pvillacorta/TP1SE/00 - Documentacion/Anotaciones/Cosas pendientes.jpeg

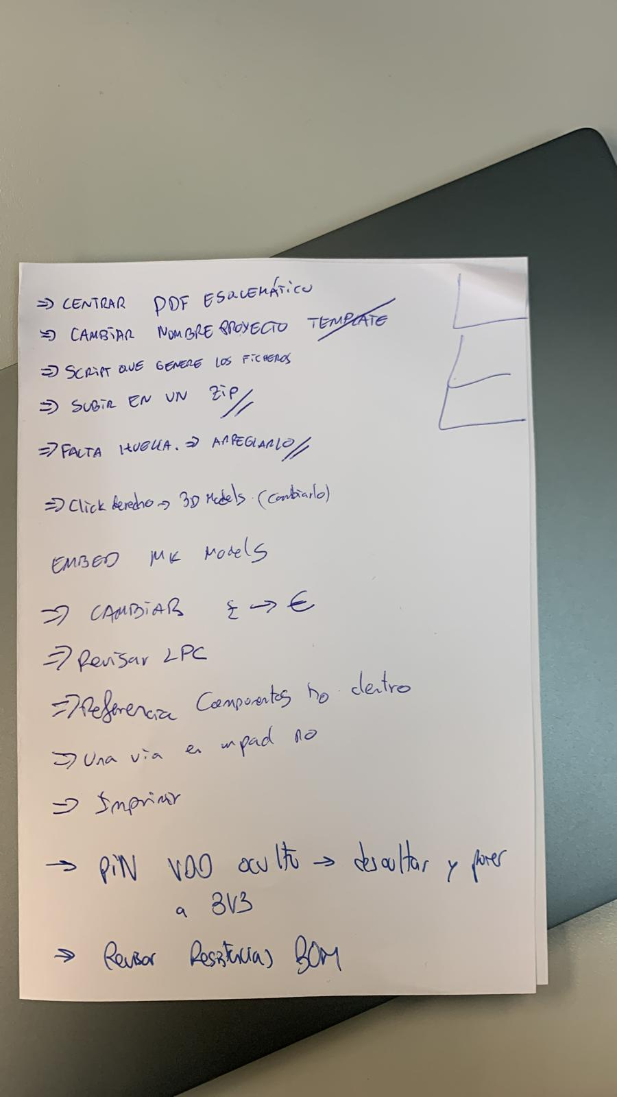
00 - Documentacion/Anotaciones/Cosas pendientes.jpeg
