pvillacorta/TP1SE/00 - Documentacion/Anotaciones/3.png

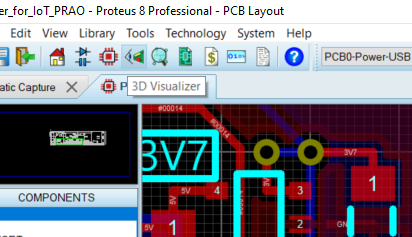
00 - Documentacion/Anotaciones/3.png
