pvillacorta/TP1SE/05 - Entregas/Entrega_21_01_23/02 - Design/Layouts/PCB2 - Mech.pdf

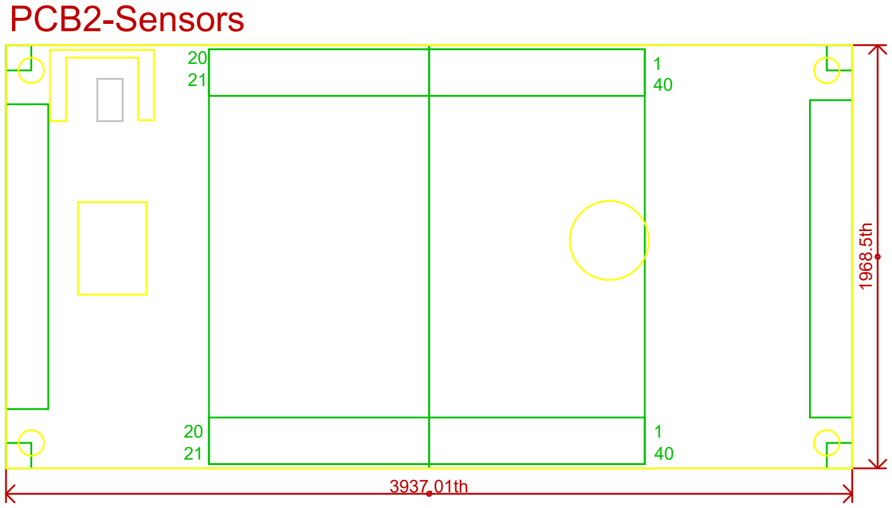
[picture p3: figure]
PCB2-Sensors
