pvillacorta/TP1SE/05 - Entregas/Entrega_21_01_23/02 - Design/Layouts/PCB0 - Mech.pdf

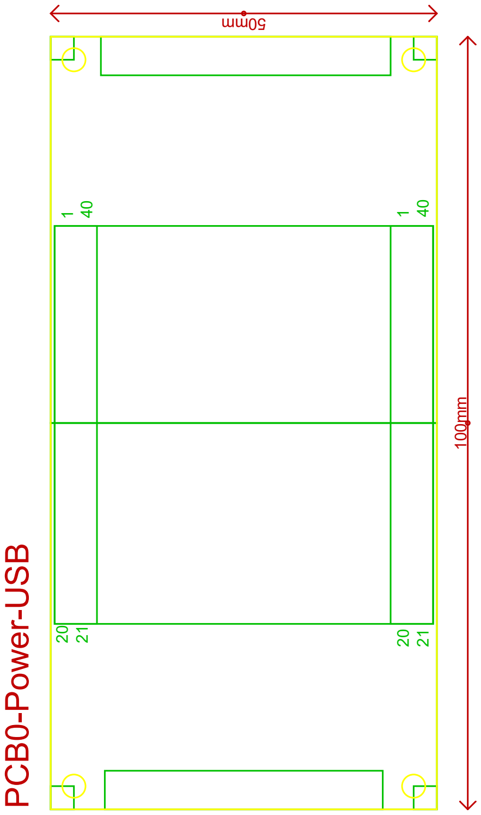
[picture p4: figure]
PCB0-Power-USB 100mm
