pvillacorta/TP1SE/05 - Entregas/Entrega_21_01_23/02 - Design/Layouts/PCB1 - Mech.pdf

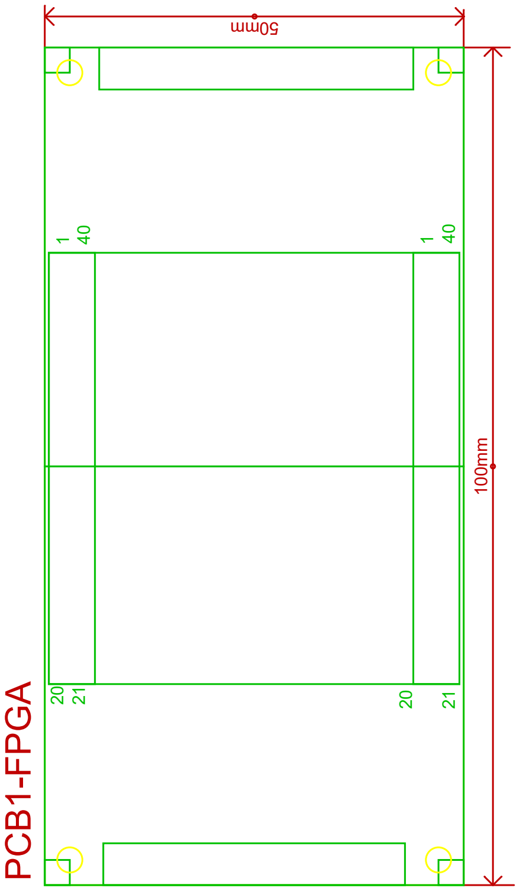
[picture p5: figure]
PCB1-FPGA
