pvillacorta/TP1SE/05 - Entregas/Entrega_21_01_23/03 - AnalisisConsumo/Analisis Electrico y Termico PCB0.pdf

Nombre | Consumo (mA) | Quiescent current (mA) | Condiciones | Ubicación | Notas
Puente USB-Serie CY7C65213-28PVXI | 13 | - | max 18 mA | Página 9. Datasheet
Regulador de tension MCP1725 (3V7) | - | 0,22 | máx 500 mA | Página 5. Datasheet | En el regulador no hay consumo de corriente, unicamente hay
| | | | | corriente quiescente, que nos situamos en el peor caso.
Nombre | Consumo (mA) | Quiescent current (mA) | Condiciones | Ubicación | Notas
Cargador Bateria MCP73831T-2ACIOT | 1,5
| | - | Cargando bateria | Página 3. Datasheet | Alimentando el datalogger con la batería no existe este consumo,
| | | | | estamos en situación máxima, la típica es 0,51mA. Si la carga está
| | | | | completa tenemos 0,053 mA de típica y 0,52 mA de máxima.
Nombre | Consumo (mA) | Quiescent current (mA) | Condiciones | Ubicación | Notas
LED rojo | 30 | - | a 25ºC | Página 2 Datasheet
LED verde | 30 | - | a 25ºC | Página 2 Datasheet
Microcontrolador ARM LPC1112FD20102/52 | 100 | - | por cada pin de alimentación (hay 1) | Página 58. Datasheet
Consumo total | 174,5
Nombre | Potencia (mW) = I * V | Resistencia térmica | Temperatura | Ubicación | Notas
Cargador Bateria MCP73831T-2ACIOT | 5,55 | 230ºC/W | - | Página 5. Datasheet
Regulador de tension MCP1725 (3V7) | 1,1 | Theta(JA) = 163ºC/W | 0,132682 ºC + Ta | Página 7. Datasheet
Puente USB-Serie CY7C65213-28PVXI | 65 | 62ºC/W | - | Página 24. Datasheet | THJ: Package 28pin SSOP
LED rojo | 75 | - | - | Página 2. Datasheet
LED verde | 75 | - | - | Página 2. Datasheet
Microcontrolador ARM LPC1112FD20102/52 | 330 | - | - | Página 58. Datasheet

Componentes a 3V7

Componentes a 3V3

Componentes a 5V

Análisis Eléctrico

Análisis Térmico
