pvillacorta/TP1SE/05 - Entregas/Entrega Semana 12/Proyecto/README.txt

Hay dos versiones del proyecto Proteus:

- Datalogger_for_IoT_PRAO_montado.pdsprj: contiene el proyecto que está montado físicamente
- Datalogger_for_IoT_PRAO.pdsprj: contiene el proyecto correcto, con los cambios realizados (ej: pines LORA_RST, LORA_CS Y LORA_SCK)
