pvillacorta/TP1SE/05 - Entregas/Entrega Semana 9/Diseño/Vistas 3D/Vista 3D - PCB1 (Trasera).pdf

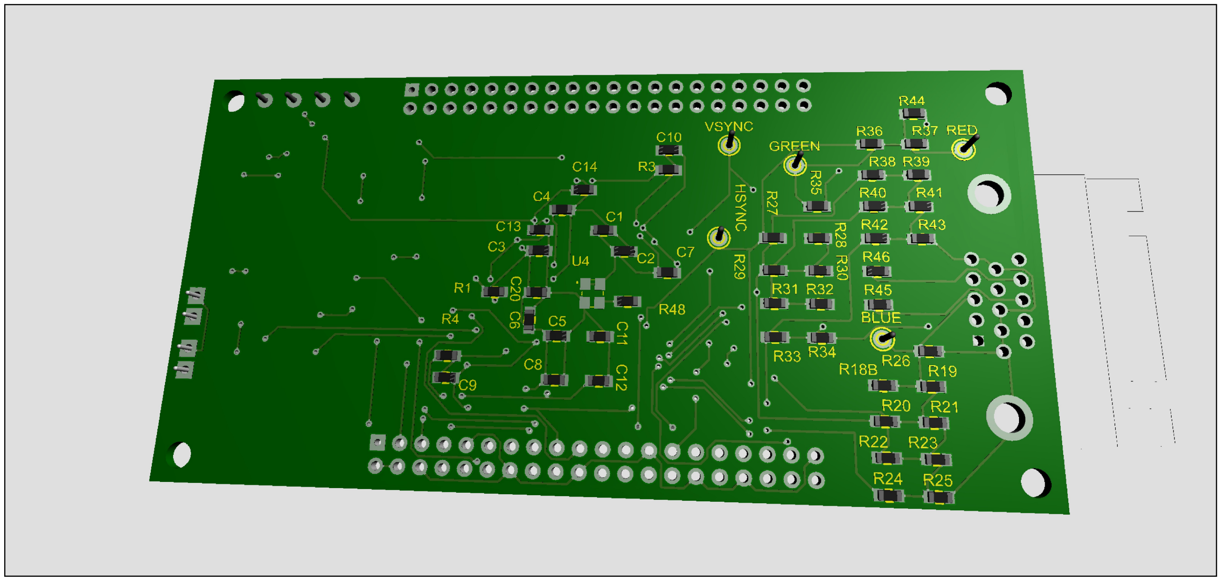
[picture p23: figure]
