pvillacorta/TP1SE/00 - Documentacion/Anotaciones/Efemerides.png

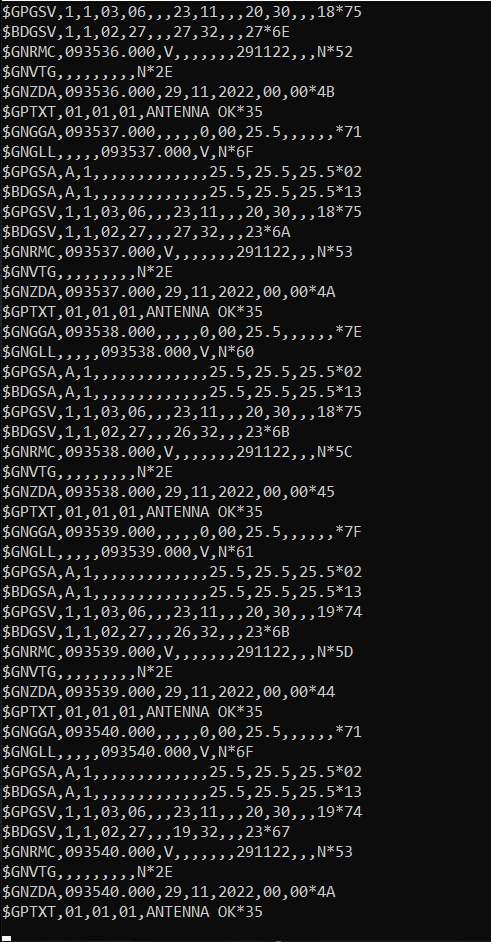
00 - Documentacion/Anotaciones/Efemerides.png
