pvillacorta/TP1SE/00 - Documentacion/Anotaciones/GeneracionGerberNotas.png

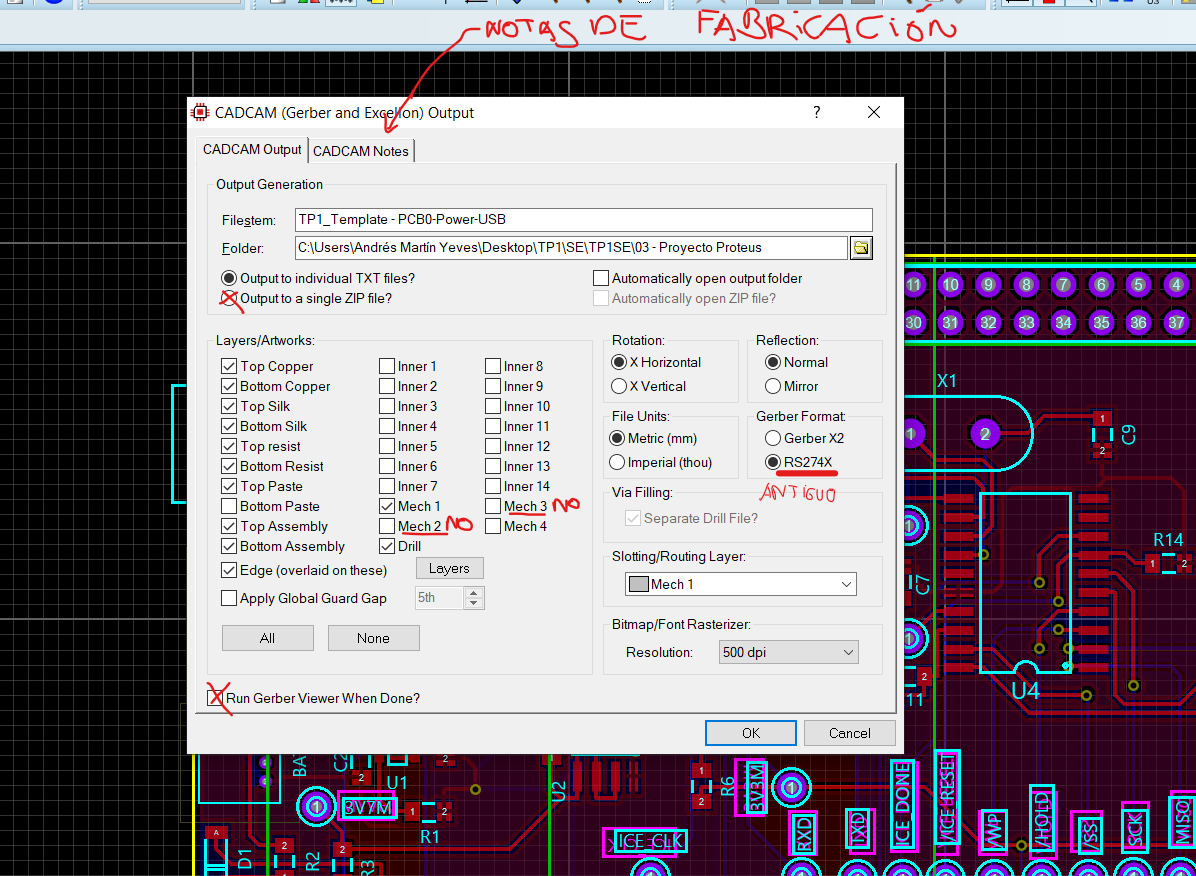
00 - Documentacion/Anotaciones/GeneracionGerberNotas.png
