pvillacorta/TP1SE/00 - Documentacion/Anotaciones/gps.png

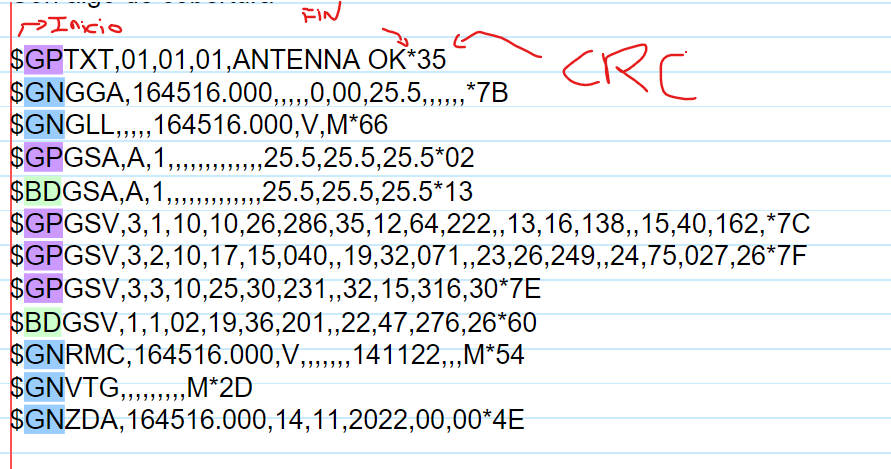
00 - Documentacion/Anotaciones/gps.png
