pvillacorta/TP1SE/00 - Documentacion/Datasheets - PCB2/BME680 Measurements.png

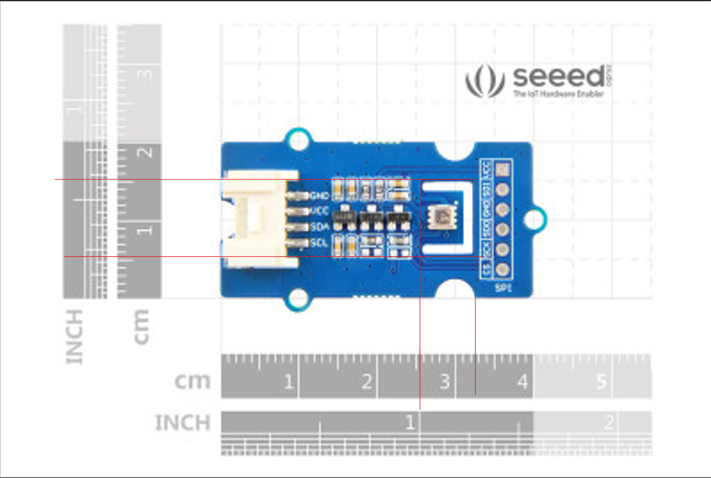
00 - Documentacion/Datasheets - PCB2/BME680 Measurements.png
