pvillacorta/TP1SE/05 - Entregas/Entrega_21_01_23/02 - Design/Layouts/PCB2 - All.pdf

# PCB2-Sensors

# PCB2-Sensors

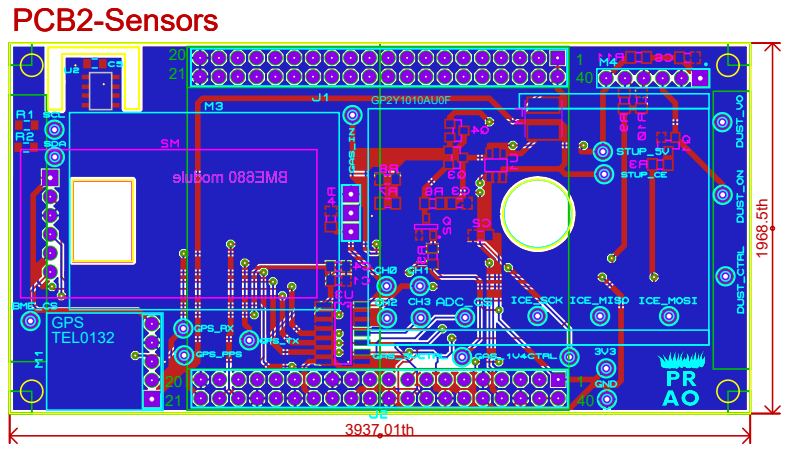
[picture p30: page 1]
TEL0132; GPS; PCB2-Sensors
