pvillacorta/TP1SE/05 - Entregas/Entrega Semana 9/Diseño/Esquemático/Esquematico.pdf

J2

5V

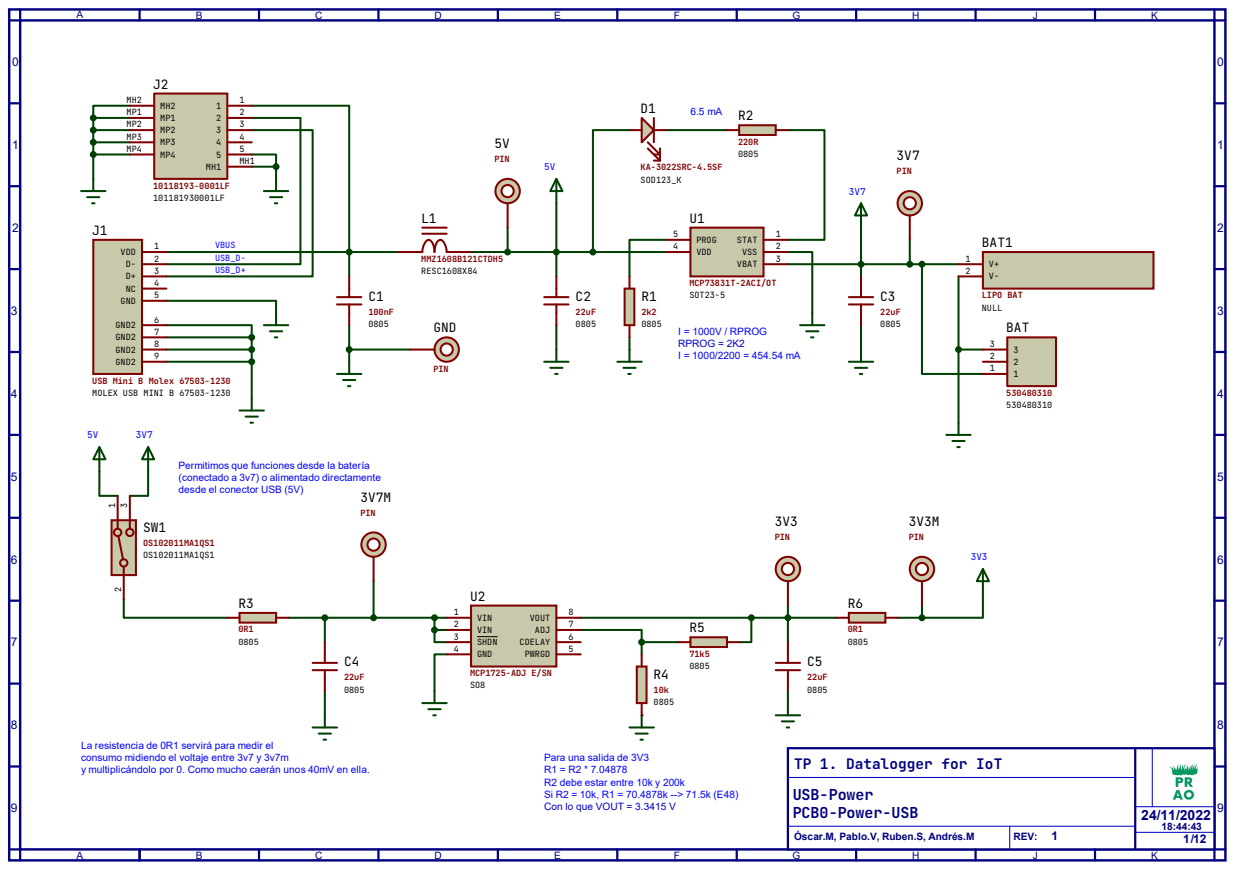
[picture p31: page 1]

Permitimos que funciones desde la batería
(conectado a 3v7) o alimentado directamente
desde el conector USB (5V)

La resistencia de 0R1 servirá para medir el
consumo midiendo el voltaje entre 3v7 y 3v7m
y multiplicándolo por 0. Como mucho caerán unos 40mV en ella.

Para una salida de 3V3
R2 debe estar entre 10k y 200k
Con lo que VOUT = 3.3415 V

TP 1. Datalogger for IoT
USB-Power

Óscar.M, Pablo.V, Ruben.S, Andrés.M

U3

## UDB_D+

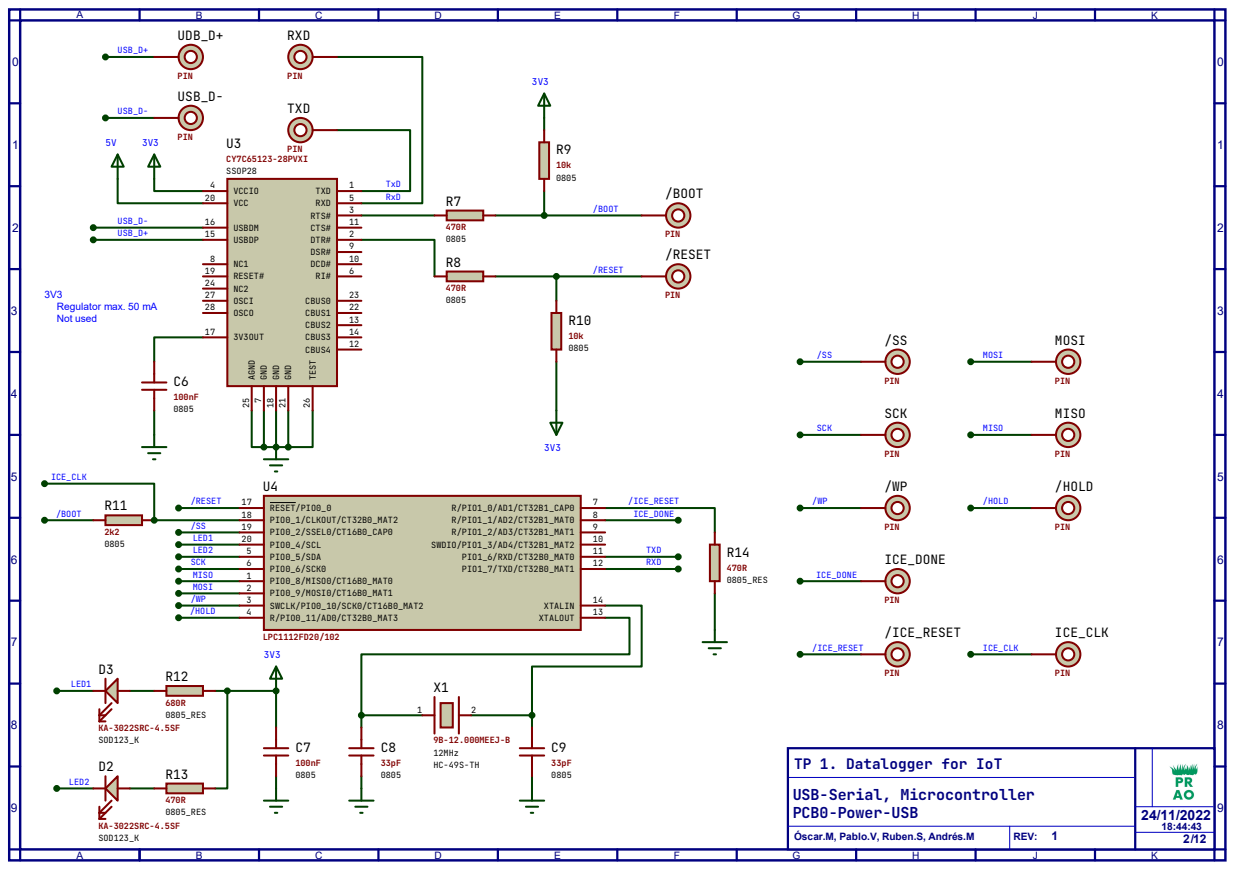
[picture p32: page 2]

TP 1. Datalogger for IoT
USB-Serial, Microcontroller

Óscar.M, Pablo.V, Ruben.S, Andrés.M

J3

J4

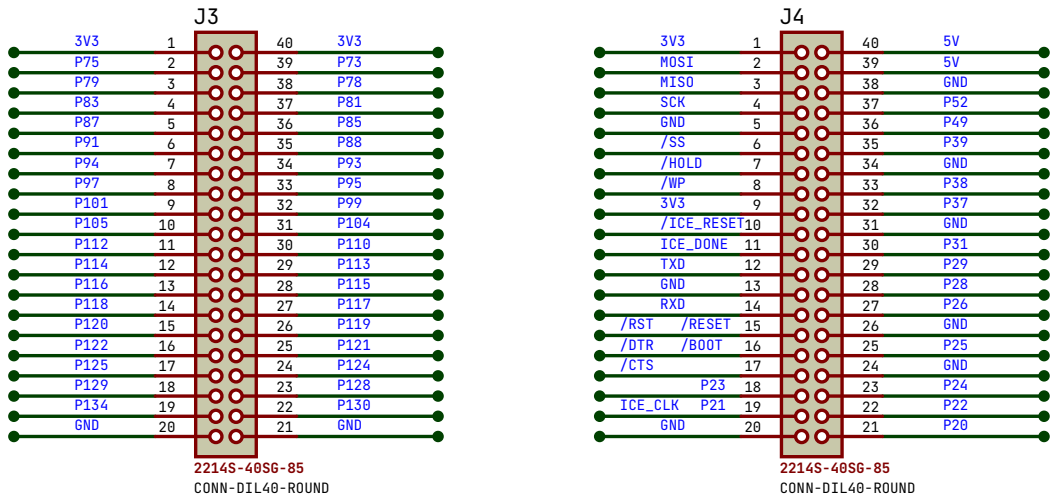
[picture p33: page 3]

TP 1. Datalogger for IoT
Conectores

Óscar.M, Pablo.V, Ruben.S, Andrés.M

# P21 ICE-CLK BANK 0

U1:A

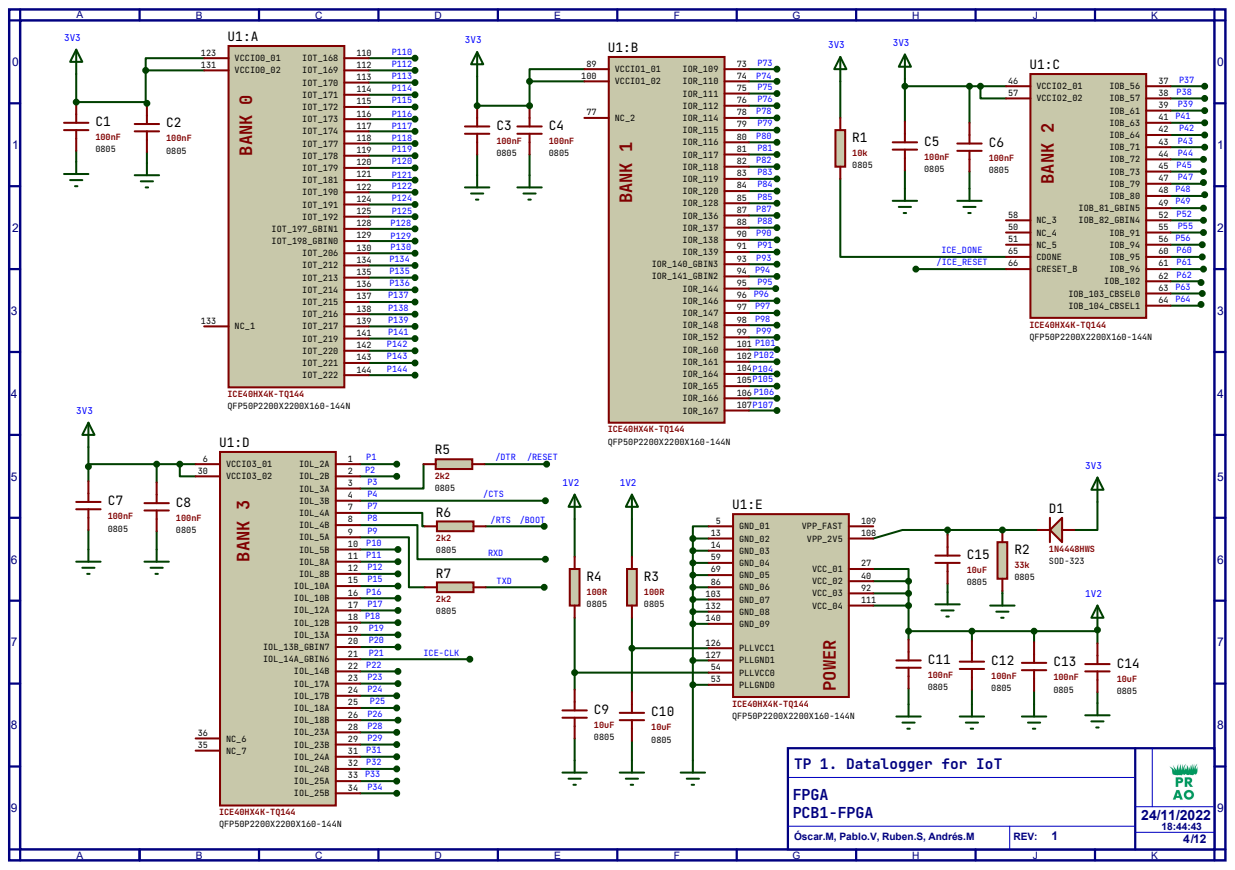
[picture p34: page 4]

TP 1. Datalogger for IoT
FPGA

Óscar.M, Pablo.V, Ruben.S, Andrés.M

U1:F
U2

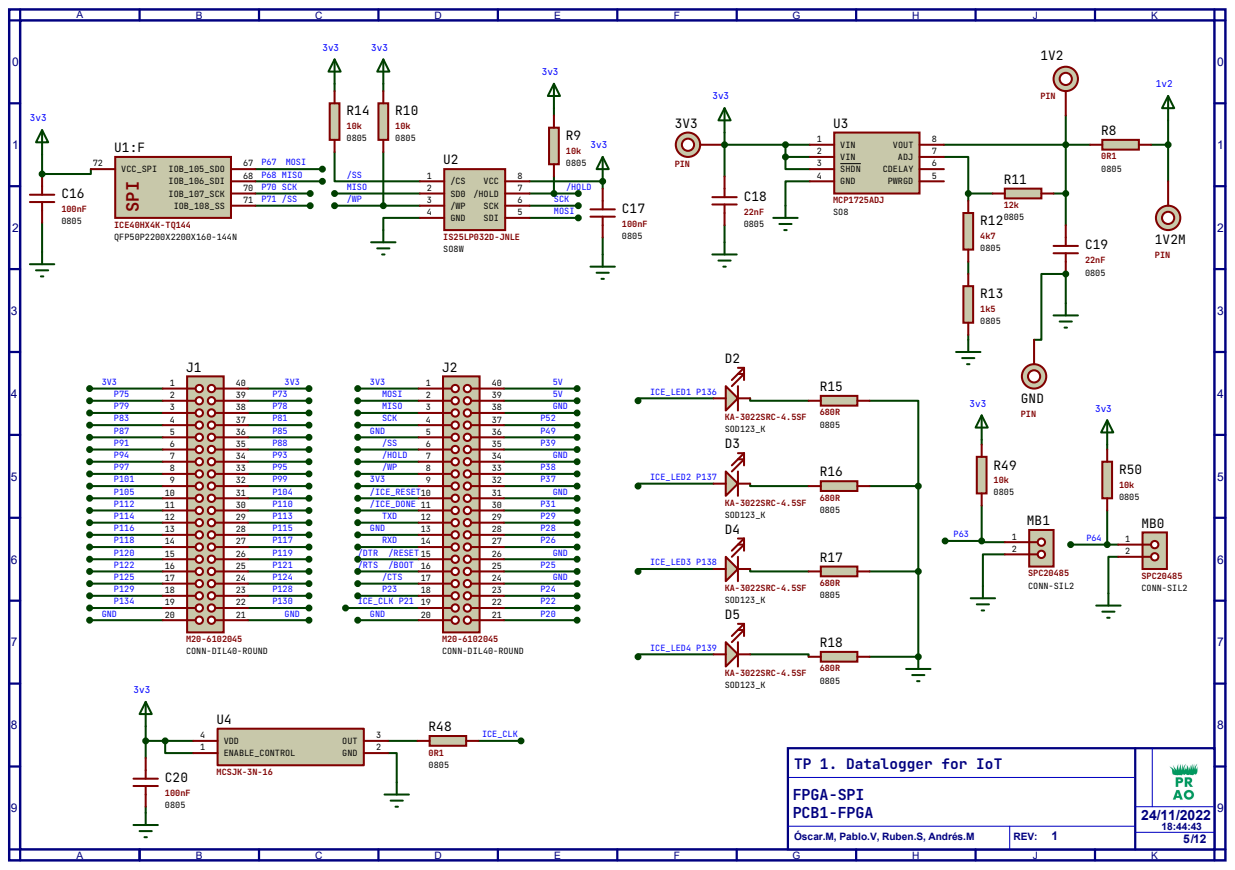
[picture p35: page 5]

TP 1. Datalogger for IoT
FPGA-SPI

Óscar.M, Pablo.V, Ruben.S, Andrés.M

## BLUE

R18B

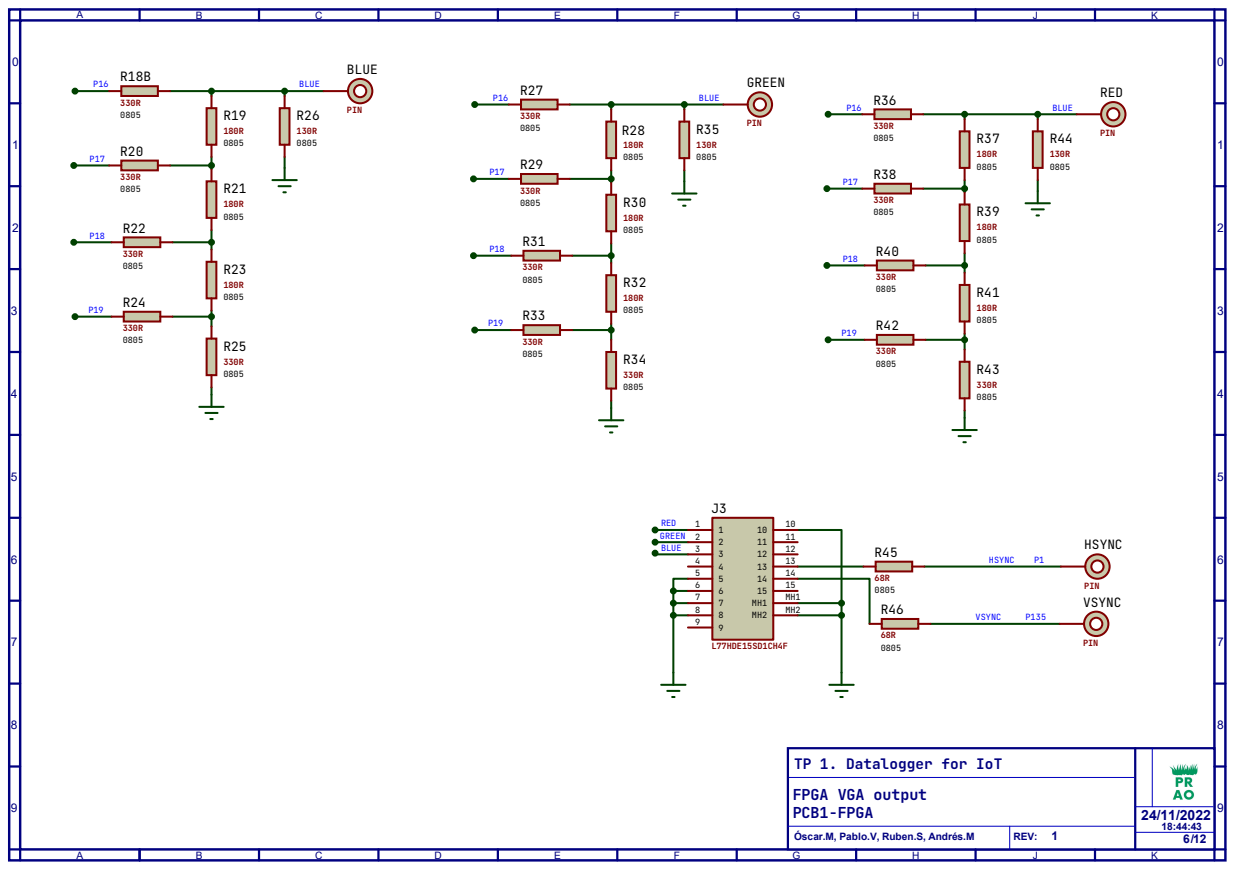
[picture p36: page 6]

TP 1. Datalogger for IoT
FPGA VGA output

Óscar.M, Pablo.V, Ruben.S, Andrés.M

L1

C3

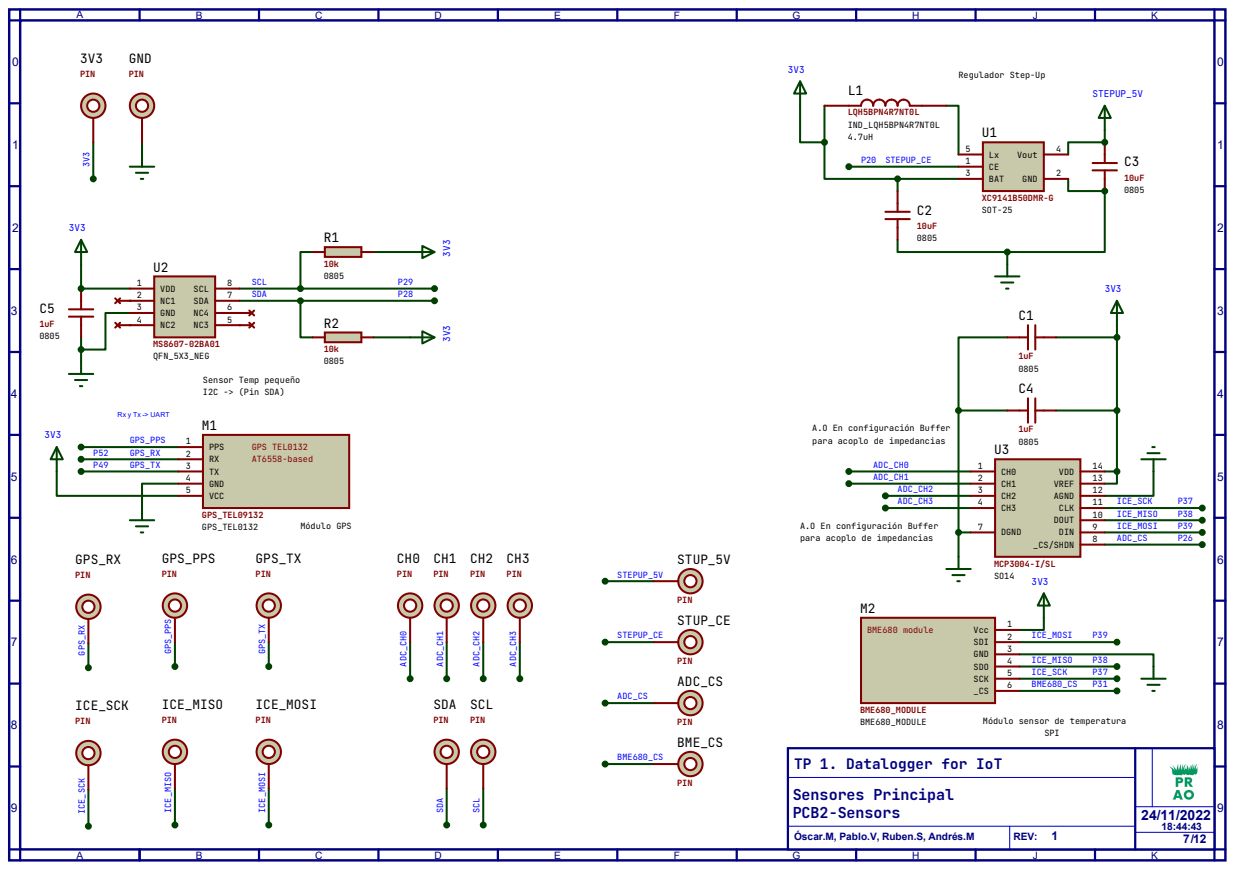
[picture p37: page 7]

A.O En configuración Buffer
para acoplo de impedancias

Módulo sensor de temperatura

TP 1. Datalogger for IoT

Óscar.M, Pablo.V, Ruben.S, Andrés.M

M3

M4

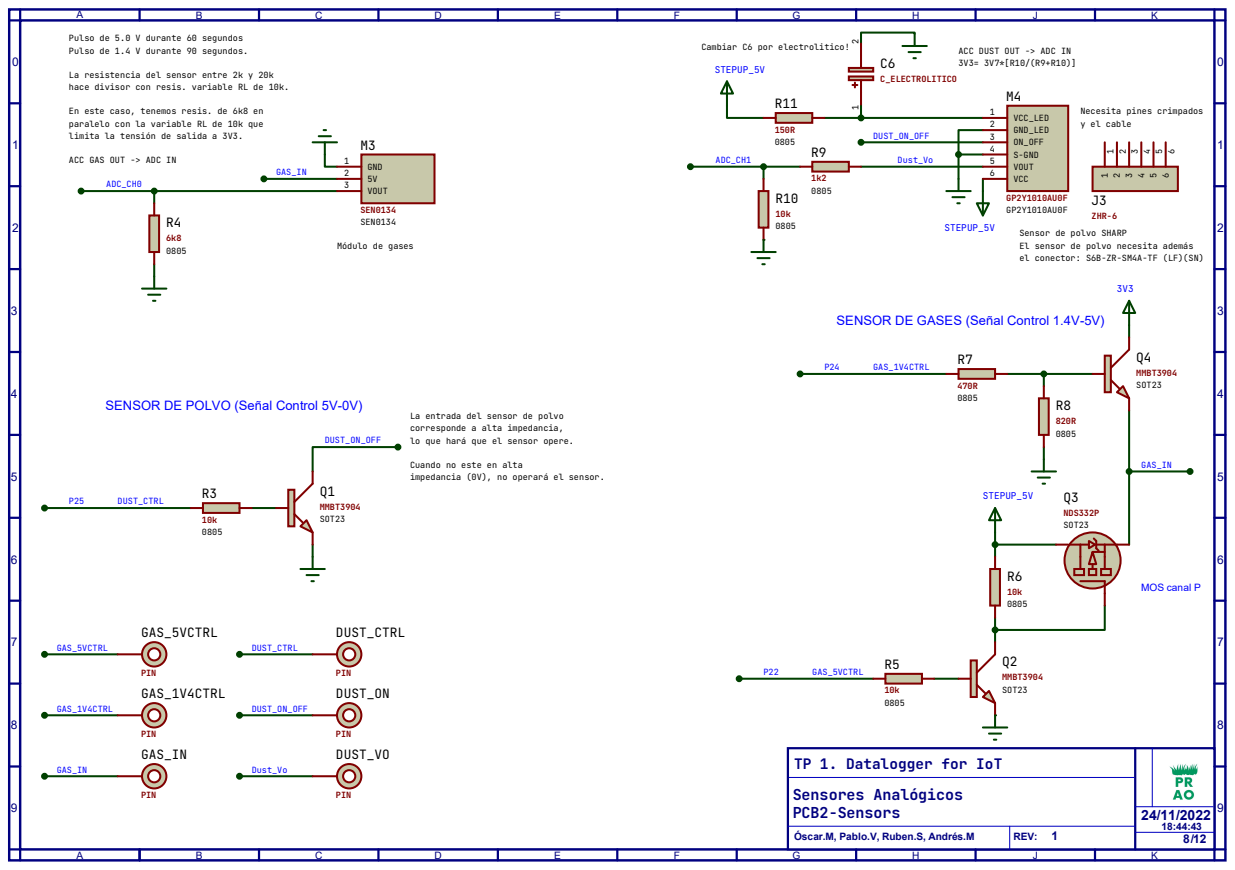
[picture p38: page 8]

Pulso de 5.0 V durante 60 segundos
Pulso de 1.4 V durante 90 segundos.

ACC DUST OUT -> ADC IN

La resistencia del sensor entre 2k y 20k
hace divisor con resis. variable RL de 10k.

En este caso, tenemos resis. de 6k8 en
paralelo con la variable RL de 10k que
limita la tensión de salida a 3V3.

Sensor de polvo SHARP
El sensor de polvo necesita además
el conector: S6B-ZR-SM4A-TF (LF)(SN)

SENSOR DE GASES (Señal Control 1.4V-5V)

SENSOR DE POLVO (Señal Control 5V-0V)

La entrada del sensor de polvo
corresponde a alta impedancia,
lo que hará que el sensor opere.

Cuando no este en alta
impedancia (0V), no operará el sensor.

TP 1. Datalogger for IoT
Sensores Analógicos

Óscar.M, Pablo.V, Ruben.S, Andrés.M

J1

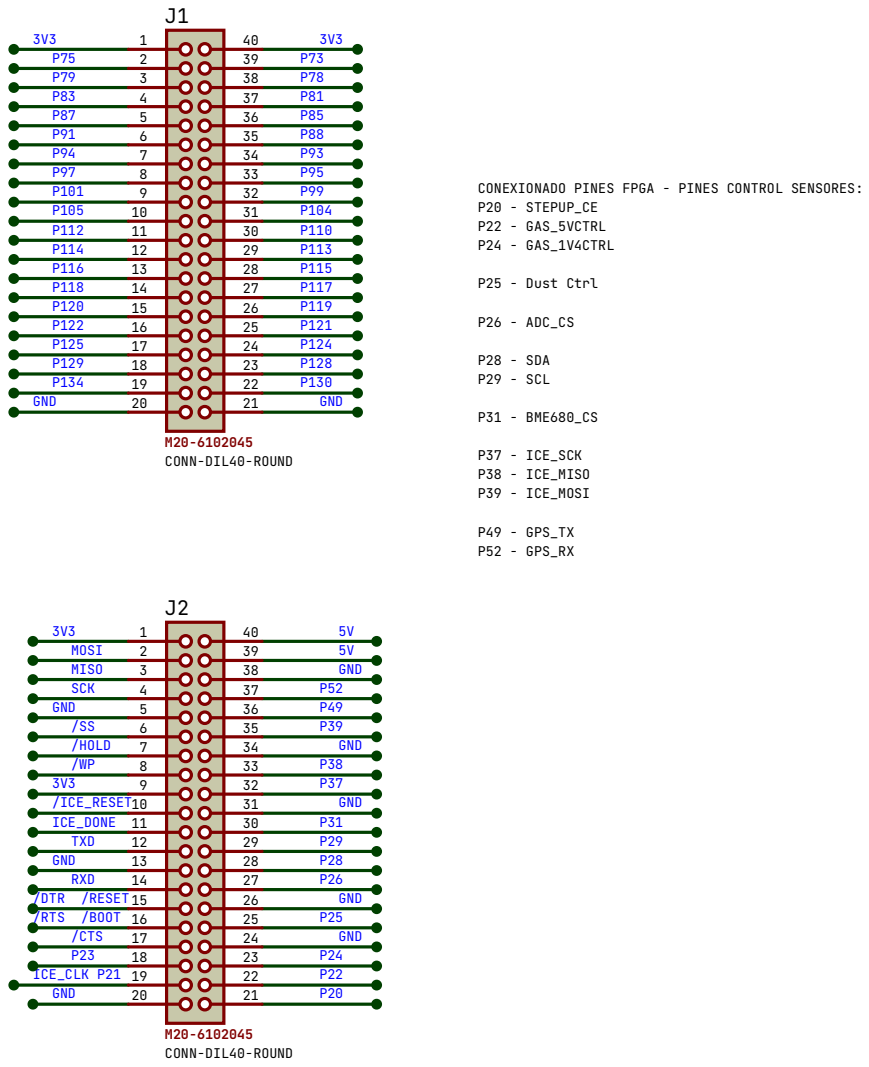
[picture p39: page 9]

TP 1. Datalogger for IoT
Conectores

Óscar.M, Pablo.V, Ruben.S, Andrés.M

J3

M1

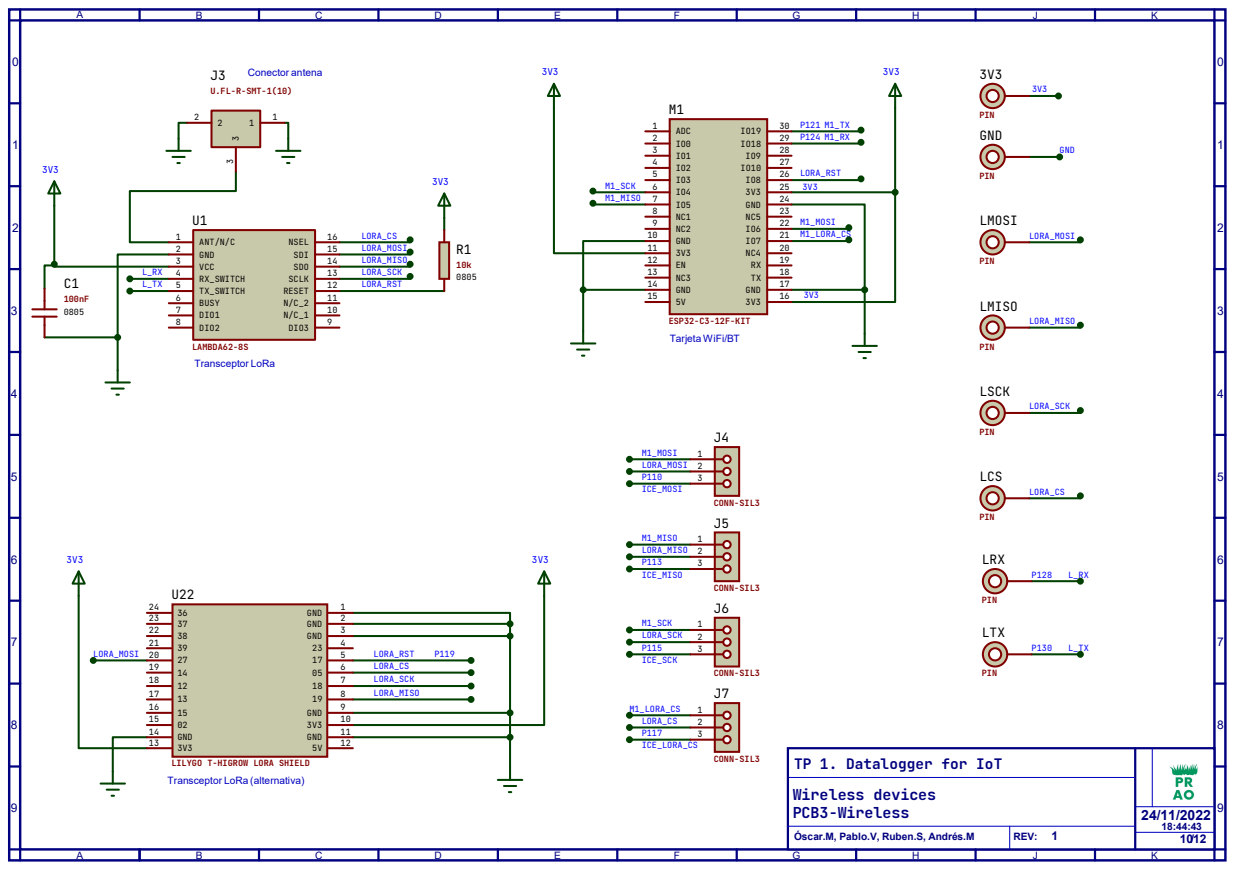
[picture p40: page 10]

LILYGO T-HIGROW LORA SHIELD
Transceptor LoRa (alternativa)

TP 1. Datalogger for IoT
Wireless devices

Óscar.M, Pablo.V, Ruben.S, Andrés.M

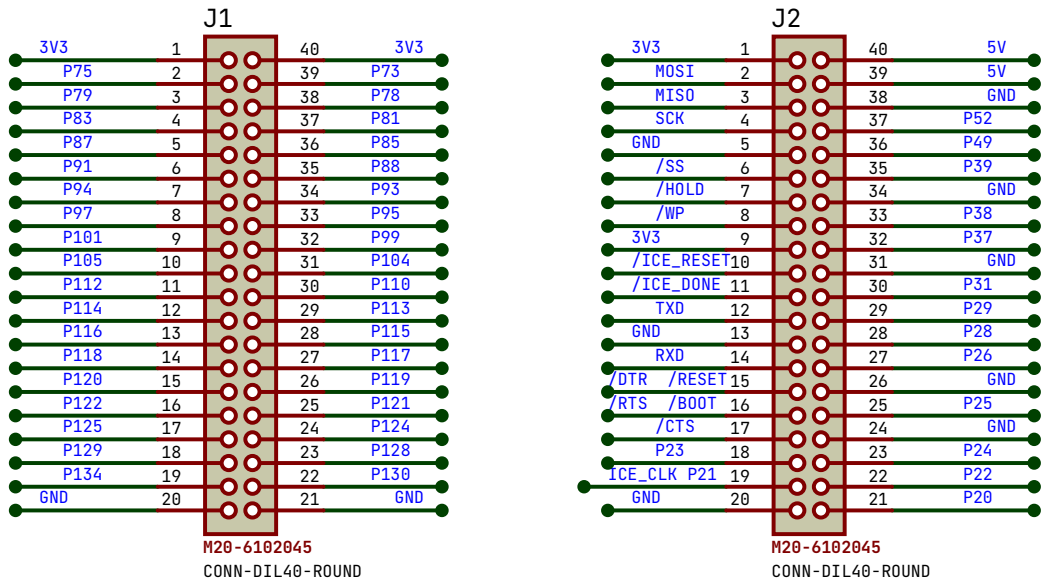
[picture p41: page 11]

TP 1. Datalogger for IoT
Conectores

Óscar.M, Pablo.V, Ruben.S, Andrés.M

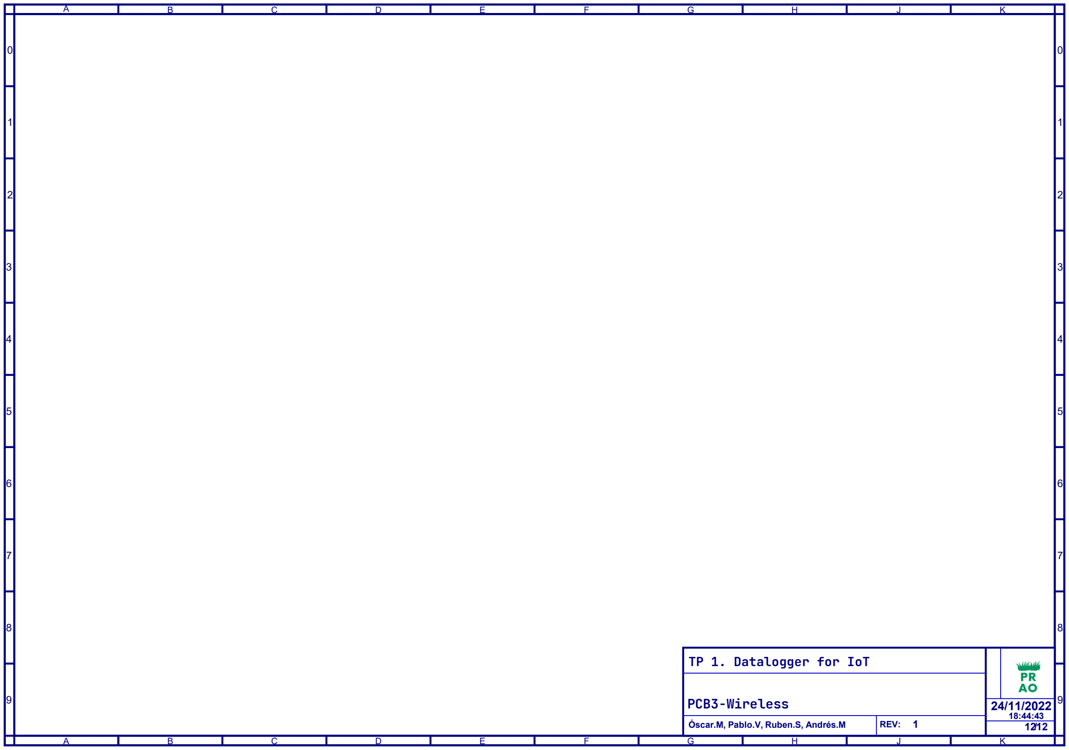
[picture p42: figure]
PCB3-Wireless; Óscar.M, Pablo.V, Ruben.S, Andrés.M; REV:; TP 1. Datalogger for IoT
