pvillacorta/TP1SE/05 - Entregas/Entrega_21_01_23/02 - Design/Layouts/PCB3 - All.pdf

# PCB3-Wireless

# PCB3-Wireless

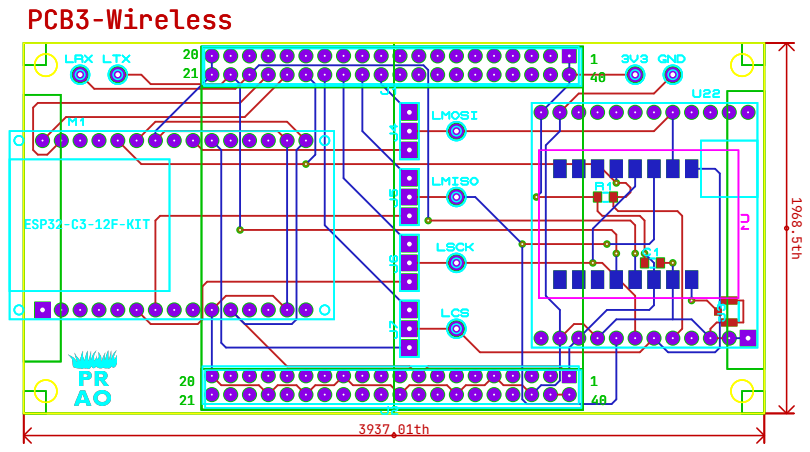
[picture p43: page 1]
ESP32-C3-12F-KIT; PCB3-Wireless
