pvillacorta/TP1SE/05 - Entregas/Entrega_21_01_23/02 - Design/Layouts/PCB3 - Bottom.pdf

# PCB3-Wireless

# PCB3-Wireless

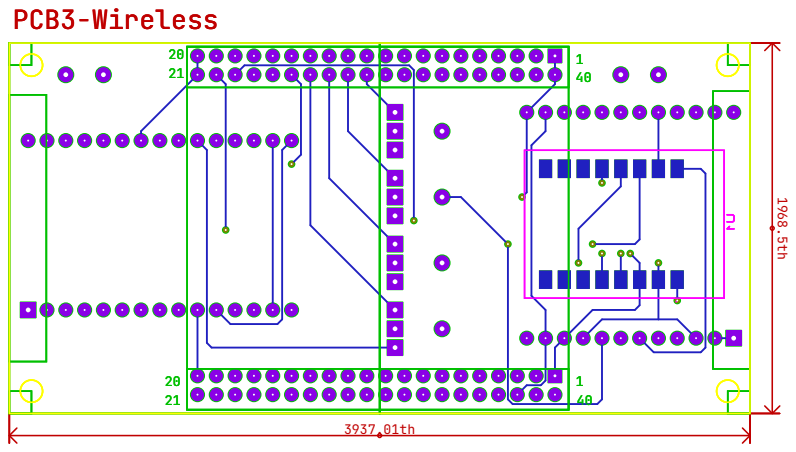
[picture p44: page 1]
PCB3-Wireless
