pvillacorta/TP1SE/05 - Entregas/Entrega_21_01_23/02 - Design/BOM/Bill Of Materials TP 1. PCB3. Datalogger for IoT.pdf

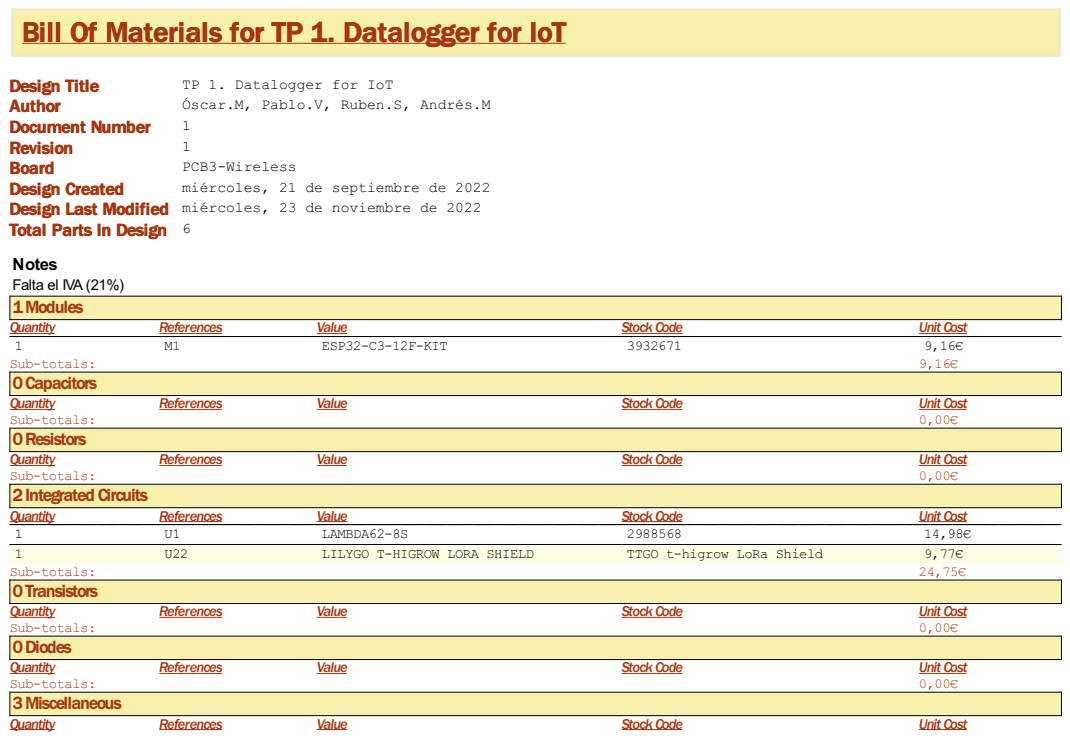
[picture p46: page 1]

Bill Of Materials for TP 1. Datalogger for IoT

Design Last Modified miércoles, 23 de noviembre de 2022
Total Parts In Design 6

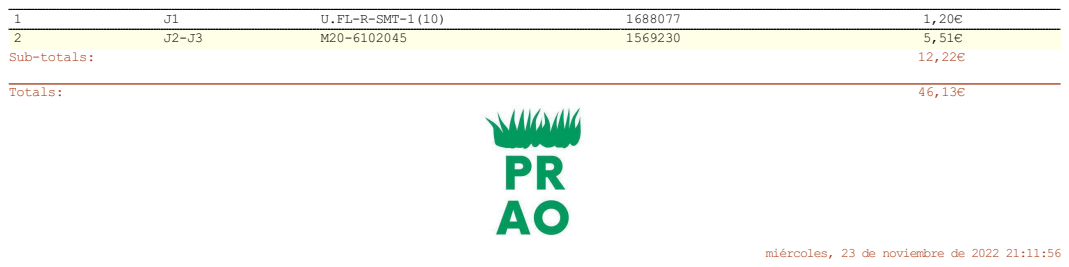
[picture p47: page 2]

miércoles, 23 de noviembre de 2022 21:11:56
