pvillacorta/TP1SE/05 - Entregas/Entrega_21_01_23/02 - Design/Layouts/PCB0 - Top.pdf

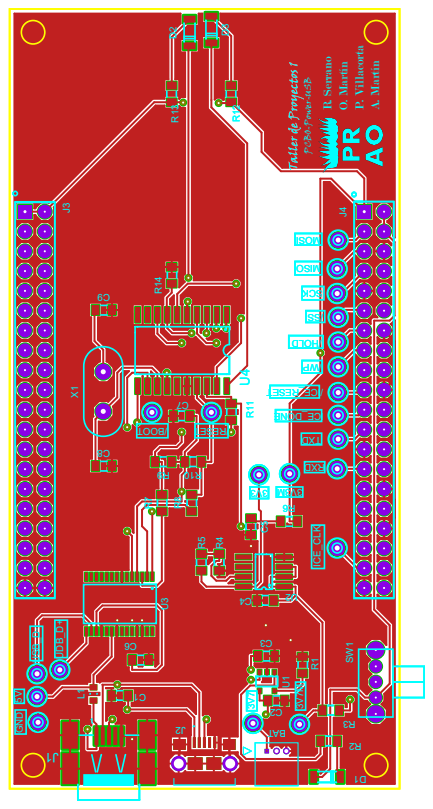
[picture p48: page 1]

PCB0-Power-USB R. Serrano O. Martín P. Villacorta A. Martín U3 U2 SW1 J3 J4 U4 X1

C7 PCB0-Power-USB R. Serrano O. Martín P. Villacorta A. Martín U3 U2 SW1 J3 J4 U4 X1
