pvillacorta/TP1SE/05 - Entregas/Entrega_21_01_23/02 - Design/Layouts/PCB1 - Top.pdf

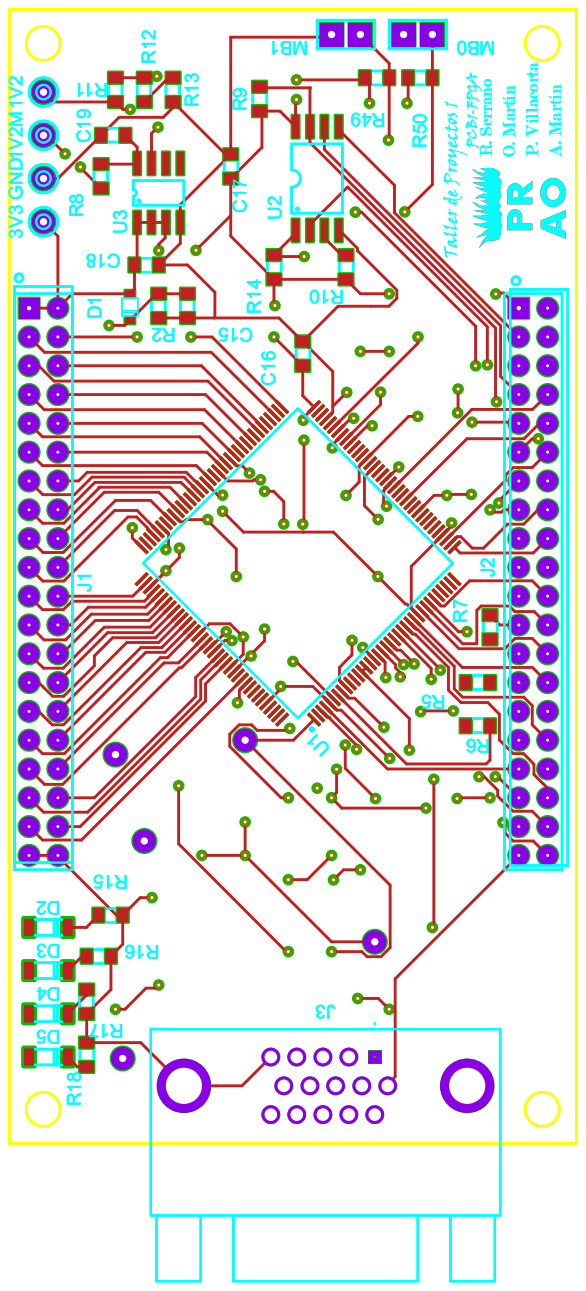
[picture p49: page 1]

PCB1-FPGA R. Serrano O. Martín P. Villacorta A. Martín R18

R5 R7 PCB1-FPGA R. Serrano O. Martín P. Villacorta A. Martín R18
