pvillacorta/TP1SE/05 - Entregas/Entrega_21_01_23/02 - Design/Layouts/PCB2 - Bottom.pdf

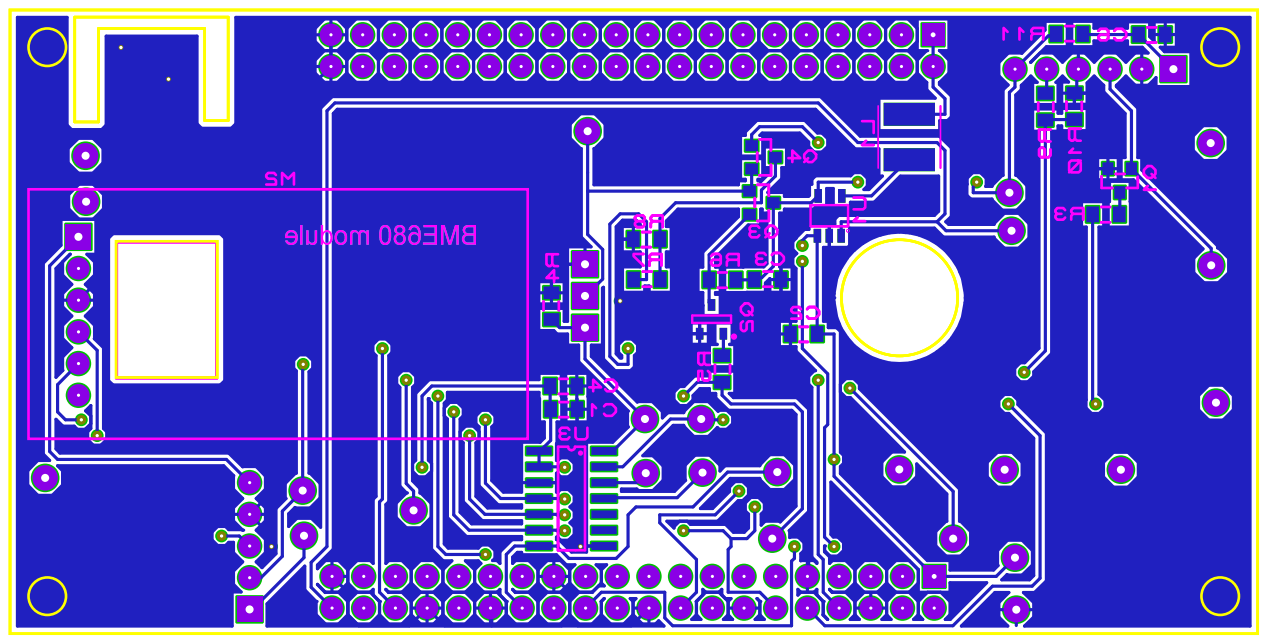
[picture p50: page 1]
