pvillacorta/TP1SE/05 - Entregas/Entrega_21_01_23/02 - Design/Layouts/PCB2 - Top.pdf

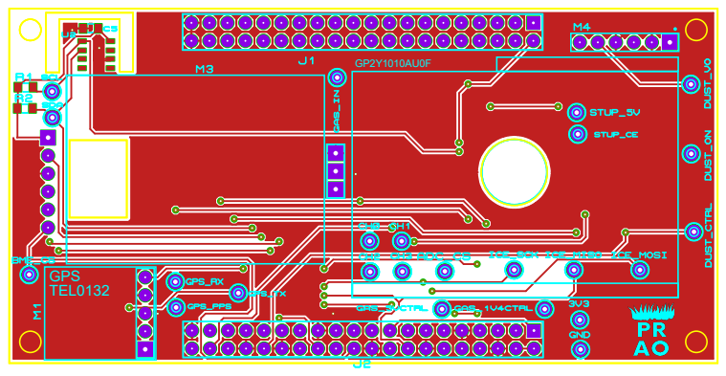
[picture p51: page 1]
TEL0132; GPS
