pvillacorta/TP1SE/05 - Entregas/Entrega_21_01_23/02 - Design/Layouts/PCB0 - Bottom.pdf

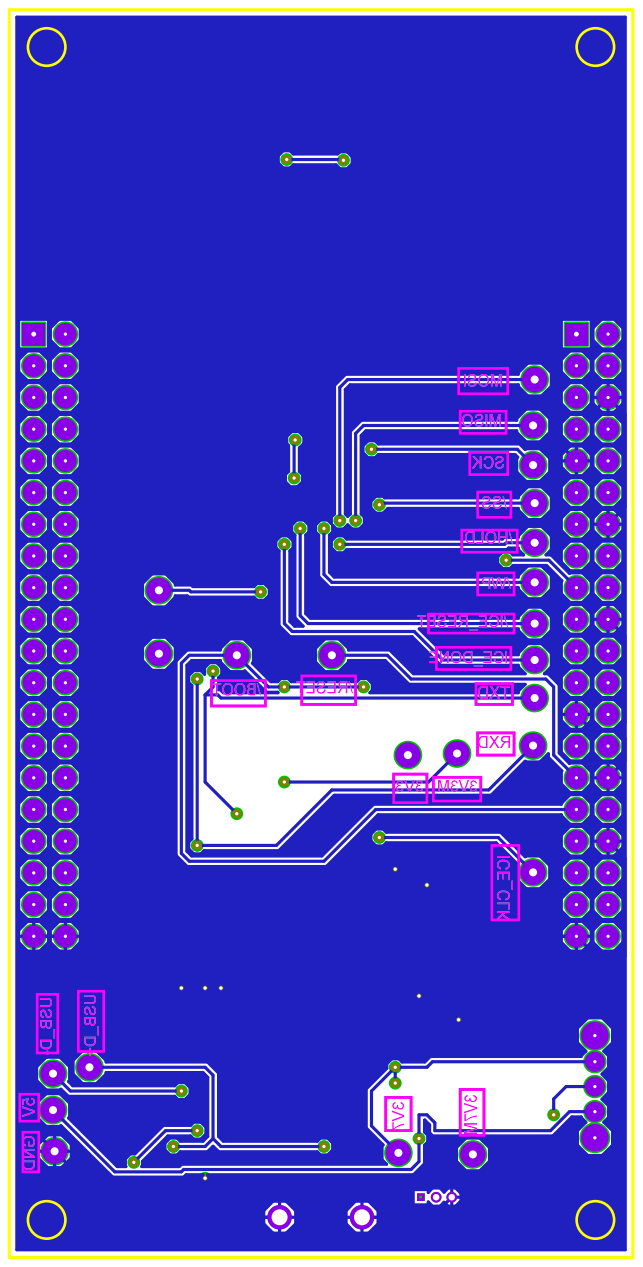
[picture p52: page 1]
