pvillacorta/TP1SE/05 - Entregas/Entrega_21_01_23/02 - Design/Layouts/PCB1 - Bottom.pdf

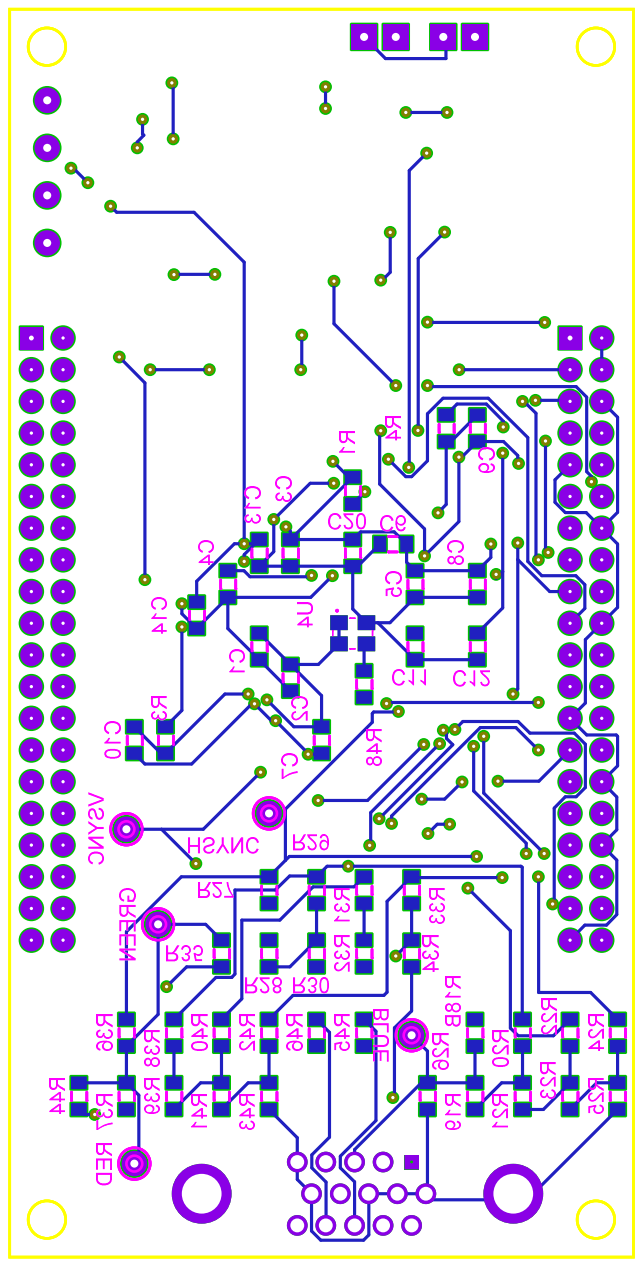
[picture p53: page 1]
