pvillacorta/TP1SE/06 - Software FPGA/laRVa_ledamos/Firmware/spiSensors.c

// =======================================================================
// Proyecto Datalogger for IoT Curso 2022-2023
// Fecha: 26/01/2023 
// Autor: Pablo Villacorta, Rubén Serrano, Óscar Martín y Andrés Martín
// Asignatura: Taller de Proyectos I
// File: spiSensors.c  
//
// Rutinas para controlar el módulo SPI0. Este SPI se encarga de la comunicación
// con el BME680 y con el ADC (a su vez, al ADC entran las salidas de los sensores
// analógicos)
// =======================================================================

// ICE_SPI 
#define BME680_CS 		0b10	//SS0 (bit0 en baja)
#define ADC_CS 			0b01	//SS1 (bit1 en baja)

////////////////////
// BME Registers  //
////////////////////

// READ / WRITE REGS
#define status_BME  		0x73   //Status [page]
#define reset_BME  			0x60
#define Id_BME  			0x50
#define Config_BME  		0x75

#define Ctrl_meas_BME  		0x74  // osrs_t [7:5] osrs_p [4:2] mode [1:0]
#define Ctrl_hum_BME  		0x72  // osrs_h [2:0]

#define Ctrl_gas_1_BME  	0x71
#define Ctrl_gas_0_BME  	0x70

#define gas_wait0			0x6D
#define gas_wait1			0x6C
#define gas_wait2			0x6B
#define gas_wait3			0x6A
#define gas_wait4			0x69
#define gas_wait5			0x68
#define gas_wait6			0x67
#define gas_wait7			0x66
#define gas_wait8			0x65
#define gas_wait9			0x64

#define res_heat0			0x63
#define res_heat1			0x62
#define res_heat2			0x61
#define res_heat3			0x60
#define res_heat4			0x5F
#define res_heat5			0x5E
#define res_heat6			0x5D
#define res_heat7			0x5C
#define res_heat8			0x5B
#define res_heat9			0x5A

// READ ONLY REGS
#define gas_r_lsb_BME		0x2B
#define gas_r_msb_BME		0x2A

#define hum_lsb_BME			0x26
#define hum_msb_BME			0x25

#define temp_xlsb_BME		0x24
#define temp_lsb_BME		0x23
#define temp_msb_BME		0x22

#define press_xlsb_BME  	0x21
#define press_lsb_BME  		0x20
#define press_msb_BME  		0x1F

#define eas_status_0_BME  	0x1D


#define RD	(0b10000000) // rw = 0 write, rw=1 read	

////////////////////
//    ADC COMM    //
////////////////////

#define CMD_START (0b00000001)
#define CMD_CH0   (0b10000000) // CHANNEL 0: Módulo de gases (SEN0134) 
#define CMD_CH1   (0b10010000) // CHANNEL 1: Sensor de Polvo (SHARP GPY1010AU0F)
#define CMD_CH2   (0b10100000) // CHANNEL 2: Unused 
#define CMD_CH3   (0b10110000) // CHANNEL 3: Unused 

// ---- TRANSFERENCIA SPI ----
// --------------------------------------------------------

uint8_t spixfer(uint8_t d)
{
	SPIDAT=d;
	while(SPISTA&1);
	return SPIDAT;
}
// ---- LECTURA BME680 ----
// --------------------------------------------------------

char readBME680(char dir){
	char dataread=0x00;
	SPISS=BME680_CS;
	spixfer(RD|dir);
	dataread = spixfer(0x00); //send dummy byte
	SPISS=0b11;
	return dataread; 
}

// ---- ESCRITURA BME680 ----
// --------------------------------------------------------

void writeBME680(char data,char dir){
	SPISS=BME680_CS;
	spixfer(dir);
	spixfer(data);
	SPISS=0b11;
}

// ---- LECTURA ADC ----
// --------------------------------------------------------
uint32_t ReadADC(char cmd_ch) // Le meto el canal
{
	unsigned char B_MSB=0, B_LSB=0; //1 Byte
	uint32_t B=0; //2 Bytes = (B_MSB B_LSB)
	
	SPISS=ADC_CS; // Selecciono el ADC
	spixfer(CMD_START); // Enviar el bit de START (BYTE CMD_START)
	B_MSB = spixfer(cmd_ch); // Envio los bits de seleccion de canal 
	//(BYTE CMD_CHi) [(diff)(D2)(D1)(D0) XXXX]
	//A la vez, recibo los primeros datos [???? ?0(B9)(B8)]
	B_LSB = spixfer(0X00); // Sent dummy Byte [0000 0000]
	//A la vez, recibo los segundos datos [(B7)(B6)(B5)(B4) (B3)(B2)(B1)(B0)]
	SPISS=0b11; //Finalizar comunicacion SPI. FIOSET = ADC_CS;
	
	B = B_MSB<<8; // Desplazo el dato 8 bits a la izquierda (B_MSB) (0000 0000)
	B|=B_LSB; // XOR con B_LSB -> (B_MSB) (0000 0000) XOR (0000 0000) (B_LSB)
	// Agregar mascara de 10 bits (0x3ff) 0b0000001111111111
	return (B&=0b0000001111111111);
}

void printAdcChannels() // In mV
{
	// ADC Digital Output code =  1024 x Vin / Vref
	// Vin = Digital Output Code x Vref / 1024 = DigOutCode >>10 x Vref (3300mV)
	
	_puts("-- ADC CHANNELS: --\n");
	_printf("Channel 0: %d mV\n",	(ReadADC(CMD_CH0)*3300)>>10);
	_printf("Channel 1: %d mV\n",	(ReadADC(CMD_CH1)*3300)>>10);
	_printf("Channel 2: %d mV\n",	(ReadADC(CMD_CH2)*3300)>>10);
	_printf("Channel 3: %d mV\n",	(ReadADC(CMD_CH3)*3300)>>10);
}

///////////////////////////////////////////////////////////////////////////////////////
//////////////////////////// 			BME680 			///////////////////////////////
///////////////////////////////////////////////////////////////////////////////////////

/* --------------------- LECTURA DE TODOS LOS REGISTROS DEL BME -----------------------
	2 páginas de registros, se selecciona una página u otra con el registro spi_mem_page:
		spi_mem_page = 0: página 0 --> 128 registros (0x80 to 0xFF)
		spi_mem_page = 1: página 1 --> 128 registros (0x00 to 0x7F)
	128*2 = 256 registros
*/


char bmeRegs[16][16];

void readAllBMERegs() 
{ 
	int i,j;
	
	// Página 0
	writeBME680(0b00000000,status_BME);
	for(i=0;i<8;i++){
		for(j=0;j<16;j++){
			bmeRegs[i+8][j] = readBME680(0x80 + 16*i + j); 
		}
	}
	
	// Página 1
	writeBME680(0b00010000,status_BME);
	for(i=0;i<8;i++){
		for(j=0;j<16;j++){
			bmeRegs[i][j] = readBME680(0x00 + 16*i + j); 
		}
	}
}

// --------------------------------------------------------

void printBMERegs(){
	int i,j;
	
	_puts("Registros del sensor BME:\n");
	
	for(i=8;i<16;i++){
		for(j=0;j<16;j++){
			_printf("%02x ",bmeRegs[i][j]);
		}
		_puts("\n");
	}
	
	_puts("\n");
	
	for(i=0;i<8;i++){
		for(j=0;j<16;j++){
			_printf("%02x ",bmeRegs[i][j]);
		}
		_puts("\n");
	}
}

// --------------------------------------------------------

char bmeReg(char dir){
	int row, col;
	
	row = dir/16;
	col = dir%16;
	
	return bmeRegs[row][col];
}


// -------------- BME init ---------------------
void startBME680(){
	// Página 1
	writeBME680(0b00010000,status_BME);
	
	// Set humidity oversampling to 1x (osrs_h = Ctrl_hum_BME[2:0] = 001)
	writeBME680(0b00000001,Ctrl_hum_BME);
	_delay_ms(1);
	
	// Set temperature oversampling to 2x (osrs_t = Ctrl_meas_BME[7:5] = 010)
	// Set pressure oversampling to 16x (osrs_p = Ctrl_meas_BME[4:2] = 101)
	writeBME680(0b01010100,Ctrl_meas_BME);
	_delay_ms(1);
	
	// Set nb_conv to 0x0 to select the previously defined heater settings (nb_conv = Ctrl_gas_1_BME[3:0])
	// Set run_gas_l to 1 to enable gas measurements  (run_gas_l = Ctrl_gas_1_BME[4])
	writeBME680(0b00010000,Ctrl_gas_1_BME);
	_delay_ms(1);
	
	// Set gas_wait_0 to 0x59 to select 100 ms heat up duration
	writeBME680(0x59,gas_wait0);
	_delay_ms(1);
	
	// Set the corresponding heater set-point by writing the target heater resistance to res_heat_0  
	writeBME680(0,res_heat0);
	_delay_ms(1);
	
	// Set mode to 0b01 to trigger a single measurement. (mode = Ctrl_meas_BME[1:0])
	writeBME680(0b01010101,Ctrl_meas_BME);
	_delay_ms(1);
}



void measureBME680(){
// Read all BME registers
readAllBMERegs();
	
/*---------------------- Temperature measurement -----------------------------
	LSB / MSB
	par_t1 0xE9 / 0xEA  
	par_t2 0x8A / 0x8B  
	par_t3 0x8C  
	temp_adc 0x24<7:4>/ 0x23 / 0x22 
*/

	int par_t1, par_t2, par_t3, temp_adc;
	int var1, var2, var3, t_fine, temp_comp;
	
	par_t1 = (int32_t)((bmeReg(0xEA) << 8) | bmeReg(0xE9));
	par_t2 = (int32_t)((bmeReg(0x8B) << 8) | bmeReg(0x8A));
	par_t3 = (int32_t)bmeReg(0x8C);
	temp_adc = (int32_t)((bmeReg(0x22)  << 12) | (bmeReg(0x23) << 4) | (bmeReg(0x24) >> 4)); 
	
	var1 = ((int32_t)temp_adc >> 3) - ((int32_t)par_t1 << 1);
	var2 = (var1 * (int32_t)par_t2) >> 11;
	var3 = ((((var1 >> 1) * (var1 >> 1)) >> 12) * ((int32_t)par_t3 << 4)) >> 14;
	t_fine = var2 + var3;
	temp_comp = ((t_fine * 5) + 128) >> 8;


/* ------------------------ Pressure measurement ----------------------------------- 

	LSB / MSB
	par_p1 0x8E / 0x8F  
	par_p2 0x90 / 0x91  
	par_p3 0x92  
	par_p4 0x94 / 0x95  
	par_p5 0x96 / 0x97  
	par_p6 0x99  
	par_p7 0x98  
	par_p8 0x9C / 0x9D  
	par_p9 0x9E / 0x9F  
	par_p10 0xA0  
	press_adc 0x21<7:4> / 0x20 / 0x1F 
*/

	int par_p1, par_p2, par_p3, par_p4, par_p5, par_p6, par_p7, par_p8, par_p9, par_p10, press_adc;
	int press_comp;

	par_p1 = (int32_t)((bmeReg(0x8F) << 8) | bmeReg(0x8E));
	par_p2 = (int32_t)((bmeReg(0x91) << 8) | bmeReg(0x90));
	par_p3 = (int32_t)bmeReg(0x92);
	par_p4 = (int32_t)((bmeReg(0x95) << 8) | bmeReg(0x94));
	par_p5 = (int32_t)((bmeReg(0x97) << 8) | bmeReg(0x96));
	par_p6 = (int32_t)bmeReg(0x99);
	par_p7 = (int32_t)bmeReg(0x98);
	par_p8 = (int32_t)((bmeReg(0x9D) << 8) | bmeReg(0x9C));
	par_p9 = (int32_t)((bmeReg(0x9F) << 8) | bmeReg(0x9E));
	par_p10 = (int32_t)bmeReg(0xA0);
	press_adc = (int32_t)((bmeReg(0x1F) << 12) | (bmeReg(0x20) << 4) | (bmeReg(0x21) >> 4));

	var1 = ((int32_t)t_fine >> 1) - 64000;
	var2 = ((((var1 >> 2) * (var1 >> 2)) >> 11) * (int32_t)par_p6) >> 2;
	var2 = var2 + ((var1 * (int32_t)par_p5) << 1);
	var2 = (var2 >> 2) + ((int32_t)par_p4 << 16);
	var1 = (((((var1 >> 2) * (var1 >> 2)) >> 13) * ((int32_t)par_p3 << 5)) >> 3) + (((int32_t)par_p2 * var1) >> 1);
	var1 = var1 >> 18;
	var1 = ((32768 + var1) * (int32_t)par_p1) >> 15;
	press_comp = 1048576 - press_adc;
	press_comp = (uint32_t)((press_comp - (var2 >> 12)) * ((uint32_t)3125));
	if (press_comp >= (1 << 30)) press_comp = ((press_comp / (uint32_t)var1) << 1);
	else press_comp = ((press_comp << 1) / (uint32_t)var1);
	var1 = ((int32_t)par_p9 * (int32_t)(((press_comp >> 3) * (press_comp >> 3)) >> 13)) >> 12;
	var2 = ((int32_t)(press_comp >> 2) * (int32_t)par_p8) >> 13;
	var3 = ((int32_t)(press_comp >> 8) * (int32_t)(press_comp >> 8) * (int32_t)(press_comp >> 8) * (int32_t)par_p10) >> 17;
	press_comp = (int32_t)(press_comp) + ((var1 + var2 + var3 + ((int32_t)par_p7 << 7)) >> 4);
	
	
/* ----------------------------- Humidity measurement ------------------------------------
	
	LSB / MSB
	par_h1 <3:0>0xE2 / 0xE3  
	par_h2 <7:4>0xE2 / 0xE1  
	par_h3 0xE4  
	par_h4 0xE5  
	par_h5 0xE6  
	par_h6 0xE7  
	par_h7 0xE8  
	hum_adc 0x26 / 0x25   
*/

	int par_h1, par_h2, par_h3, par_h4, par_h5, par_h6, par_h7, hum_adc;
	int temp_scaled, hum_comp, var4, var5, var6;
	
	par_h1 = (int32_t)((bmeReg(0xE3) << 4) | (bmeReg(0xE2) & 0b00001111));
	par_h2 = (int32_t)((bmeReg(0xE1) << 4) | (bmeReg(0xE2) >> 4));
	par_h3 = (int32_t)bmeReg(0xE4);
	par_h4 = (int32_t)bmeReg(0xE5);
	par_h5 = (int32_t)bmeReg(0xE6);
	par_h3 = (int32_t)bmeReg(0xE7);
	par_h3 = (int32_t)bmeReg(0xE8);
	hum_adc = (int32_t)((bmeReg(0x25) << 8) | bmeReg(0x26));
	
	temp_scaled = (int32_t)temp_comp;
	var1 = (int32_t)hum_adc - (int32_t)((int32_t)par_h1 << 4) - (((temp_scaled * (int32_t)par_h3) / ((int32_t)100)) >> 1);
	var2 = ((int32_t)par_h2 * (((temp_scaled * (int32_t)par_h4) / ((int32_t)100)) + (((temp_scaled * ((temp_scaled * (int32_t)par_h5) / ((int32_t)100))) >> 6) / ((int32_t)100)) + ((int32_t)(1 << 14)))) >> 10;
	var3 = var1 * var2;
	var4 = (((int32_t)par_h6 << 7) + ((temp_scaled * (int32_t)par_h7) / ((int32_t)100))) >> 4;
	var5 = ((var3 >> 14) * (var3 >> 14)) >> 10;
	var6 = (var4 * var5) >> 1;
	hum_comp = (((var3 + var6) >> 10) * ((int32_t) 1000)) >> 12;
	
	// -----------------------------------------------------------------

	temp = temp_comp/100;
	presion = press_comp/100;
	humedad = hum_comp/1000;
	
	_printf("Temperatura: %d%cC\n", temp, 167);
	_printf("temp_adc: %d\n", temp_adc);
	_printf("Presion: %d hPascal\n", presion);
	_printf("Humedad: %d%c\n", humedad, 37);	
}

///////////////////////////////////////////////////////////////////////////////////////
//////////////////////////// 		ANALOG SENSORS  	///////////////////////////////
///////////////////////////////////////////////////////////////////////////////////////


void ReadDust(){ // Sensor de particulas
	
	GPOUT = (STEPUP_CE|ice_led4); //Activa El step Up y el led 4 que indica lectura Polvo
	clkMode=3; //Modo Sensor de polvo
	TCNT =(0.00968)*CCLK; //Configuramos el reloj cada 10 mseg - 0,32ms = 9,68ms = 0.00968 seg 
	
}

void ReadGAS(){ // Sensor de GAS SEN0134

	_printf("-- ENABLE GAS SENSOR --\n"
	"Config: Step Up Enabled\n"
	"60 seg -> 5V (while LEFT LED)\n"
	"90 seg -> 1V4 (while RIGHT LED)"
	"\n");
	// LED IZQUIERDA Indica 5V
	// LED DERECHA   Indica 1V4
	clkMode=1;
}

void printCO(){ //
	_printf("\n COValue (mV): %d\n",COValue);
}

void printDust(){ //
	_printf("\n polvoValue (mV): %d\n",polvoValue);
	
	// Seria necesario un Acondicionamiento: Factor 25/28 = 0.9
	// Funcion de transferencia del sensor: V= 5 * P + Offset
	// Offset tipico 0,9, (min 0 max 1.5) -> Spg Offset = 0.4 mg/m^3, Sens = 5000mv / (mg/m^3)
	// Polvo = ( ((Dig * 3300mv / 1024) / 0.9 ) - Offset=0.4 ) / 5

}

void printCh4LPG(){ //
	_printf("\n Ch4LPGValue (mV): %d\n",Ch4LPGValue);

}
