pvillacorta/TP1SE/05 - Entregas/Entrega_21_01_23/04 - Software/laRVa_ledamos/main.v

// =======================================================================
// RISC-V things
// by Jesús Arias
//--------------------------------------------------------------------
// -> EDITED:
// Proyecto Datalogger for IoT Curso 2022-2023
// Fecha: 05/12/2022 
// Autor: Pablo Villacorta, Rubén Serrano, Óscar Martín y Andrés Martín
// Asignatura: Taller de Proyectos I
// File: main.v (top level entity)
// Incorpora las entradas en la FPGA de los modulos agregados
// =======================================================================
`include "system.v"
`include "pll.v"

// Top module. (signals assigned to actual pins in file "pines.pcf")
module main(
	input  CLKIN, 		// Input clock from crystal oscillator (16MHz)
	// SPI0
	output ICE_SCK,
	output ICE_MOSI,
	output BME680_CS, //ss0
	output ADC_CS,	  //ss1
	input  ICE_MISO,
	
	// SPI1
	output LoRA_SCK,
	output LoRA_RST,
	output LoRA_MOSI,
	output LoRA_CS, //ss
	input  LoRA_MISO,
	
	// GPOUT
	output GPOUT0,	// ice_led1
	output GPOUT1,  // ice_led2
	output GPOUT2,  // ice_led3
	output GPOUT3,  // ice_led4
	output GPOUT4,  // STEPUP_CE
	output GPOUT5,  // GAS_5V_CTRL
	output GPOUT6,	// GAS_1V4_CTRL
	output GPOUT7,	// DUST_CTRL
	
	// GPIN
	input GPIN0,	//P112 GPIN0	
	input GPIN1,	//P113 GPIN1
	input GPIN2,	//P114 GPIN2
	input GPIN3,	//P115 GPIN3
	input GPIN4,	//P116 GPIN4
	input GPIN5,	//P117 GPIN5
	input GPIN6,	//P118 GPIN6
	input GPIN7,	//P119 GPIN7
	
	// UART0	
	input RXD0,
	output TXD0,
	// UART1	
	input RXD1,
	output TXD1,
	// UART2	
	input RXD2,
	output TXD2,
	
	output FSS	// Flash SS
);

//-- PLL: generates a 25MHz master clock from a 16MHz input
wire clk,pll_lock;

pll
  pll1(
	.clock_in(CLKIN),
	.clock_out(clk),
	.locked(pll_lock)
	);

//assign clk=CLKIN;
//assign pll_lock=1'b1;

// Game controller and SPI pin mappings
assign JY4=1'b1;	// Game controller power
wire [7:0]pinin;

//assign XBHE=1'b0;
//assign XBLE=1'b0;

// Instance of the system
SYSTEM sys1( .clk(clk), .reset(reset),
		.txd0(TXD0), .rxd0(RXD0),
		.txd1(TXD1), .rxd1(RXD1),
		.txd2(TXD2), .rxd2(RXD2),
		.ice_sck(ICE_SCK), .ice_mosi(ICE_MOSI), .ice_miso(ICE_MISO), .ice_ss0(BME680_CS), .ice_ss1(ADC_CS), 
		.iceLoRA_sck(LoRA_SCK), .iceLoRA_mosi(LoRA_MOSI), .iceLoRA_miso(LoRA_MISO), .iceLoRA_ss(LoRA_CS), .iceLoRA_RST(LoRA_RST), 
		.gpout0(GPOUT0), .gpout1(GPOUT1), .gpout2(GPOUT2), .gpout3(GPOUT3),
		.gpout4(GPOUT4), .gpout5(GPOUT5), .gpout6(GPOUT6), .gpout7(GPOUT7),
		.gpin0(GPIN0), .gpin1(GPIN1), .gpin2(GPIN2), .gpin3(GPIN3),
		.gpin4(GPIN4), .gpin5(GPIN5), .gpin6(GPIN6), .gpin7(GPIN7),
		.fssb(FSS)
);

// Automatic RESET pulse: Reset is held active for 255 cycles after PLL lock

reg [21:0]cnt=22'h3fffff;
wire reset=(cnt!=0);

always @(posedge clk) cnt<= reset ? cnt-1: cnt;


//////////////////////////////////////////////////////
// Bidirectional data bus of the external RAM
// Tristates have to be instantiated usign the SB_IO module (specific of the ICE40 FPGA)

wire [15:0]xdi;	// internal data input bus
wire [15:0]xdo;	// internal data output bus

//////////////////////////////////////////////////////
// SB_IOs
wire oe;
assign oe=XOE; // activate tristates on writes (XOE inactive == High)

SB_IO #( .PIN_TYPE(6'b 1010_01), .PULLUP(1'b 0) ) xd_instance0
(   .PACKAGE_PIN(   XD[0]),
    .OUTPUT_ENABLE( oe   ),
    .D_OUT_0(       xdo[0]),
    .D_IN_0(        xdi[0]) );
SB_IO #( .PIN_TYPE(6'b 1010_01), .PULLUP(1'b 0) ) xd_instance1
(   .PACKAGE_PIN(   XD[1]),
    .OUTPUT_ENABLE( oe   ),
    .D_OUT_0(       xdo[1]),
    .D_IN_0(        xdi[1]) );
SB_IO #( .PIN_TYPE(6'b 1010_01), .PULLUP(1'b 0) ) xd_instance2
(   .PACKAGE_PIN(   XD[2]),
    .OUTPUT_ENABLE( oe   ),
    .D_OUT_0(       xdo[2]),
    .D_IN_0(        xdi[2]) );
SB_IO #( .PIN_TYPE(6'b 1010_01), .PULLUP(1'b 0) ) xd_instance3
(   .PACKAGE_PIN(   XD[3]),
    .OUTPUT_ENABLE( oe   ),
    .D_OUT_0(       xdo[3]),
    .D_IN_0(        xdi[3]) );
SB_IO #( .PIN_TYPE(6'b 1010_01), .PULLUP(1'b 0) ) xd_instance4
(   .PACKAGE_PIN(   XD[4]),
    .OUTPUT_ENABLE( oe   ),
    .D_OUT_0(       xdo[4]),
    .D_IN_0(        xdi[4]) );
SB_IO #( .PIN_TYPE(6'b 1010_01), .PULLUP(1'b 0) ) xd_instance5
(   .PACKAGE_PIN(   XD[5]),
    .OUTPUT_ENABLE( oe   ),
    .D_OUT_0(       xdo[5]),
    .D_IN_0(        xdi[5]) );
SB_IO #( .PIN_TYPE(6'b 1010_01), .PULLUP(1'b 0) ) xd_instance6
(   .PACKAGE_PIN(   XD[6]),
    .OUTPUT_ENABLE( oe   ),
    .D_OUT_0(       xdo[6]),
    .D_IN_0(        xdi[6]) );
SB_IO #( .PIN_TYPE(6'b 1010_01), .PULLUP(1'b 0) ) xd_instance7
(   .PACKAGE_PIN(   XD[7]),
    .OUTPUT_ENABLE( oe   ),
    .D_OUT_0(       xdo[7]),
    .D_IN_0(        xdi[7]) );

SB_IO #( .PIN_TYPE(6'b 1010_01), .PULLUP(1'b 0) ) xd_instance8
(   .PACKAGE_PIN(   XD[8]),
    .OUTPUT_ENABLE( oe   ),
    .D_OUT_0(      xdo[8]),
    .D_IN_0(       xdi[8]) );
SB_IO #( .PIN_TYPE(6'b 1010_01), .PULLUP(1'b 0) ) xd_instance9
(   .PACKAGE_PIN(   XD[9]),
    .OUTPUT_ENABLE( oe   ),
    .D_OUT_0(      xdo[9]),
    .D_IN_0(       xdi[9]) );
SB_IO #( .PIN_TYPE(6'b 1010_01), .PULLUP(1'b 0) ) xd_instance10
(   .PACKAGE_PIN(   XD[10]),
    .OUTPUT_ENABLE( oe   ),
    .D_OUT_0(       xdo[10]),
    .D_IN_0(        xdi[10]) );
SB_IO #( .PIN_TYPE(6'b 1010_01), .PULLUP(1'b 0) ) xd_instance11
(   .PACKAGE_PIN(   XD[11]),
    .OUTPUT_ENABLE( oe   ),
    .D_OUT_0(      xdo[11]),
    .D_IN_0(       xdi[11]) );
SB_IO #( .PIN_TYPE(6'b 1010_01), .PULLUP(1'b 0) ) xd_instance12
(   .PACKAGE_PIN(   XD[12]),
    .OUTPUT_ENABLE( oe   ),
    .D_OUT_0(      xdo[12]),
    .D_IN_0(       xdi[12]) );
SB_IO #( .PIN_TYPE(6'b 1010_01), .PULLUP(1'b 0) ) xd_instance13
(   .PACKAGE_PIN(   XD[13]),
    .OUTPUT_ENABLE( oe   ),
    .D_OUT_0(      xdo[13]),
    .D_IN_0(       xdi[13]) );
SB_IO #( .PIN_TYPE(6'b 1010_01), .PULLUP(1'b 0) ) xd_instance14
(   .PACKAGE_PIN(   XD[14]),
    .OUTPUT_ENABLE( oe   ),
    .D_OUT_0(      xdo[14]),
    .D_IN_0(       xdi[14]) );
SB_IO #( .PIN_TYPE(6'b 1010_01), .PULLUP(1'b 0) ) xd_instance15
(   .PACKAGE_PIN(   XD[15]),
    .OUTPUT_ENABLE( oe   ),
    .D_OUT_0(      xdo[15]),
    .D_IN_0(       xdi[15]) );

endmodule
