pvillacorta/TP1SE/06 - Software FPGA/laRVa_ledamos/Firmware/gpin.c

// =======================================================================
// Proyecto Datalogger for IoT Curso 2022-2023
// Fecha: 26/01/2023
// Autor: Pablo Villacorta, Rubén Serrano, Óscar Martín y Andrés Martín
// Asignatura: Taller de Proyectos I
// File: gpin.c  
// =======================================================================

// GPIN 
#define GPIN0 		(0b00000001)	//P73 GPIN0 -> J1 [39]    
#define GPIN1 		(0b00000010)	//P78 GPIN1 -> J1 [38] 
#define GPIN2 		(0b00000100)	//P81 GPIN2 -> J1 [37]  
#define GPIN3 		(0b00001000)	//P85 GPIN3 -> J1 [36]  
#define GPIN4 		(0b00010000)	//P88 GPIN4 -> J1 [35] 
#define GPIN5 		(0b00100000)	//P93 GPIN5 -> J1 [34]   
#define GPIN6 		(0b01000000)	//P95 GPIN6 -> J1 [33]  
#define GPIN7 		(0b10000000)	//P99 GPIN7 -> J1 [32] 

const static char *gpintxt="\n"
"\n---------------------------------- PINES GPIN ----------------------------------\n"
"\n                                      J1\n"
" --- --- --- --- --- --- --- --- --- --- --- --- --- --- --- --- --- --- --- ---\n"         
"| x | x | x | x | x | x | x | x | x | x | x | x | x | x | x | x | x | x | x | x |\n"        
" --- --- --- --- --- --- --- --- --- --- --- --- --- --- --- --- --- --- --- ---\n"        
" --- --- --- --- --- --- --- --- --- --- --- --- --- --- --- --- --- --- --- ---\n"         
"| x | x | x | x | x | x | x | x | x | x | x |GP7|GP6|GP5|GP4|GP3|GP2|GP1|GP0| x |\n"        
" --- --- --- --- --- --- --- --- --- --- --- --- --- --- --- --- --- --- --- ---\n"
"\n"
"\n                                      J2\n"
" --- --- --- --- --- --- --- --- --- --- --- --- --- --- --- --- --- --- --- ---\n"         
"| x | x | x | x | x | x | x | x | x | x | x | x | x | x | x | x | x | x | x | x |\n"       
" --- --- --- --- --- --- --- --- --- --- --- --- --- --- --- --- --- --- --- ---\n"
" --- --- --- --- --- --- --- --- --- --- --- --- --- --- --- --- --- --- --- ---\n"         
"| x | x | x | x | x | x | x | x | x | x | x | x | x | x | x | x | x | x | x | x |\n"       
" --- --- --- --- --- --- --- --- --- --- --- --- --- --- --- --- --- --- --- ---\n"  
"\n"; 

 // ---- Lectura GPIN ----
void GpinRead(void)
{
	_puts(gpintxt);
	_puts("GPIN:");
	_printfBin(GPIN);
	_puts("\n");
}
