pvillacorta/TP1SE/(commit log)

2022-09-22 es un readme para saber si tengo bien el repositorio
2022-09-22 Modificado el doc de cambios
2022-09-23 Diagrama de Gant, dos primeras partes del proyecto
2022-09-23 completo, pero hay que cuadrar tiempos
2022-09-23 Actualiación de diagrama de Gantt
2022-09-23 Actualización del Control de Cambios
2022-09-27 Renombrados los esquemáticos correspondientes a cada PCB
2022-09-29 Actualizar Control de Cambios
2022-09-29 Diagramas de Gant finales. Se han creado dos para su futura comparacion y decision
2022-09-30 Actualizacion Andres Fin de semana
2022-10-04 nueva carpeta para tener el análisis de consumo y de disispación
    [AnalisisConsumo.xlsx]
2022-10-04 Generacion Esq y BOM
2022-10-06 Actualización control de cambios Martes 04/10
2022-10-06 Continuando con el esquemático de la PCB-1
2022-10-06 Subida de todos los cambios y añadidos realizados el 6 de octubre
2022-10-06 analisis electrico
    [AnalisisConsumo.xlsx]
2022-10-06 Correción error en diodos leds de esquematico placa 1: pagina2
2022-10-06 Analisis electrico, no me ha dado a mucho mas luego sigo si veis este coment
    [AnalisisConsumo.xlsx]
2022-10-06 se me habia olvidado modificar el control de cambios
2022-10-11 Comenzado el posicionamiento de componentes en la PCB1
2022-10-13 PCB0 fin
2022-10-13 Upload Analisis térmico
    [AnalisisConsumo.xlsx]
2022-10-13 Comenzando el enrutado de componentes en la PCB1
2022-10-14 Finalización del enrutado de la placa 1, control de cambios
2022-10-14 Análisis consumo
    [AnalisisConsumo.xlsx]
2022-10-14 Control de cambios
2022-10-18 no se por que pero me dice que commitee
2022-10-18 Se ha incluido de nuevo la PCB0. Fichero BOM de la placa 1
2022-10-19 Actualizado fichero de cambios
2022-10-19 Añadidos componentes de la PCB1 al análisis eléctrico y térmico. Hay componentes de los cuales no encuentro información
    [AnalisisConsumo.xlsx]
2022-10-19 Actualizado fichero de control de cambios
2022-10-20 Documentacion PCB2
2022-10-20 Updated Análisis PCB 0 y 1
    [AnalisisConsumo.xlsx]
2022-10-20 Add files via upload
    Cambio en el nombre del proyecto y reestructuración de directorios.
2022-10-20 Updated Control de cambios + Diagrama de Gannt a medias
2022-10-21 Finalizado Diagrama de Gannt
2022-10-21 iba a generar los layput pero vi que estaban hechos ya. Lo que he hecho ha sido de pasarlo de fichero prn a pdf para que se pueda ver en todos los dispositivos sin problema
2022-10-21 cambio de un fichero prn a pdf para que se pueda ver en todos los dispositivos
2022-10-21 cambio en el control de cambios del 21/10. Cambio en la frase Finalizacion diagrama de gannt por Cambios en el diagrama de gannt
2022-10-27 Actualizacion Andres sensores
2022-10-27 Huellas sensores Andres
2022-10-29 Actualización PCB2 Sensores
2022-10-29 Circuitos de acondicionamiento Sensores
2022-10-31 Resistencias cambio
2022-11-03 Algunos compontentes de la placa 3
2022-11-05 Análisis placa 2
    [AnalisisConsumo.xlsx]
2022-11-05 Upload Datasheets PCB3
2022-11-06 poner bien el nombre del pdf
2022-11-06 Análisis Placa 1
    [AnalisisConsumo.xlsx]
2022-11-06 Subida de nuevos ficheros generados para la entrega
    [AnalisisConsumo.xlsx]
2022-11-08 Añadidos componentes al esquemático de la PCB3
2022-11-10 Cambios de la PCB 2 jueves 10/11
2022-11-10 PCB3: corrección de errores en componentes del esquemático
2022-11-21 actualizacion diagrama de gannt
2022-11-22 Diseño PCB 2
2022-11-23 PCB2 Rutada
2022-11-24 actualización del control de cambios pablo y ruben
2022-11-24 PCB3 esquematico y placa
2022-11-24 actualizacion del proyecto con la pcb3. El bom se ha modificado pero no se ha subido que estamos en clase y eso llevaria tiempo (quiero apuntar cosas)
2022-11-24 Arreglado lo de la PCB3 y añadida la footprint del condensador electrolítico
2022-11-27 Análisis Consumo PCB3
    [AnalisisConsumo.xlsx]
2022-11-27 Entrega Semana 9 y Control de cambios
2022-12-01 Añadida tabla que indica las direcciones de memoria para cada periférico
2022-12-02 he metido lo que llevaba hecho del SPI
2022-12-04 actualizacion del diagram de gannt, realizacion de la entrega sed la semana 10
2022-12-06 Larvaledamos con errores losiento :)
    [estadisticoHorasEmpleadas.xlsx]
2022-12-06 Ctrl de cambios
2022-12-07 Test Exito nueva UART
2022-12-07 Quizas corregido error con interrupciones
    [system.v]
2022-12-12 Añadido fichero spi
2022-12-12 Cambios en el readme
2022-12-13 Continuación con la implementación del SPI
2022-12-14 Ctrl Cambios
    [estadisticoHorasEmpleadas.xlsx]
2022-12-15 Acualizacion SPI y GPOUT
2022-12-20 Pruebas con el sensor BME por SPI
2022-12-20 SPI Depuracion
2022-12-21 SPI Recibiendo VIVA
2022-12-22 SPI LecturayEscritura
2022-12-24 Actualizacion Estadistico y control de cambios
    [estadisticoHorasEmpleadas.xlsx]
2023-01-08 Documentación Técnica
    [AnalisisConsumo.xlsx]
2023-01-10 Continuación con las rutinas del BME, no consigo escribir/leer en los registros de este sensor
2023-01-10 Actualizado control de cambios
2023-01-11 Continuación con la obtención de los datos proporcionados por el BME. Ya está todo encarrilado
2023-01-11 Actualizacion Estadistico
    [estadisticoHorasEmpleadas.xlsx]
2023-01-12 Añadido directorio de la entrega semana 12
2023-01-12 Añadido directorio para la entrega semana 12
2023-01-12 Renamed Planificacion
    [estadisticoHorasEmpleadas.xlsx]
2023-01-12 Renamed v2
    [AnalisisConsumo.xlsx]
2023-01-16 actualizacion diagrama de gannt 16enero
2023-01-19 Control cambios y renombrado de algunos ficheros
2023-01-23 lora spi
2023-01-23 ahora deberia no dar error
    [spiLoRa.c]
2023-01-24 cambios en la transmision Lora, comprobado que la escritura en la fifo funciona, solo falta que transmita el dato
2023-01-25 Estadisticas trabajo y control de cambios
    [estadisticoHorasEmpleadas.xlsx]
2023-01-25 Diagrama de Gannt actualizado y finiquitado
2023-01-25 PDF con el diagrama de Gannt
2023-01-25 subida de mas pdfs de gannt
2023-01-27 Quitados algunos comentarios del código y actualizado control de cambios
2023-01-27 Prueba fix errores merge
    [system.v]
2023-01-27 Ahora sí, fixed (era un error en main.c)
    [main.c]
